Alfredobud/Handyman-project/projetos-madeira/clientes/teste1/cerca-trancada/referencias/referencia-cerca-trancada.jpg

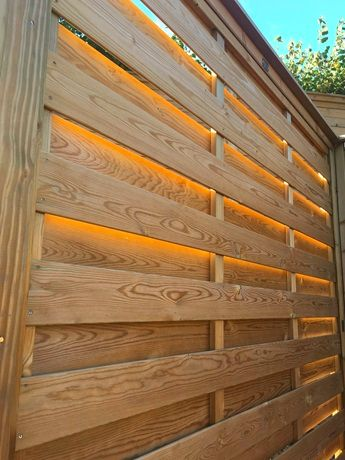
projetos-madeira/clientes/teste1/cerca-trancada/referencias/referencia-cerca-trancada.jpg
