Alfredobud/Handyman-project/projetos-madeira/clientes/bill/kitchen-privacy-screen/referencias/referencia-rev8-6-postes.webp

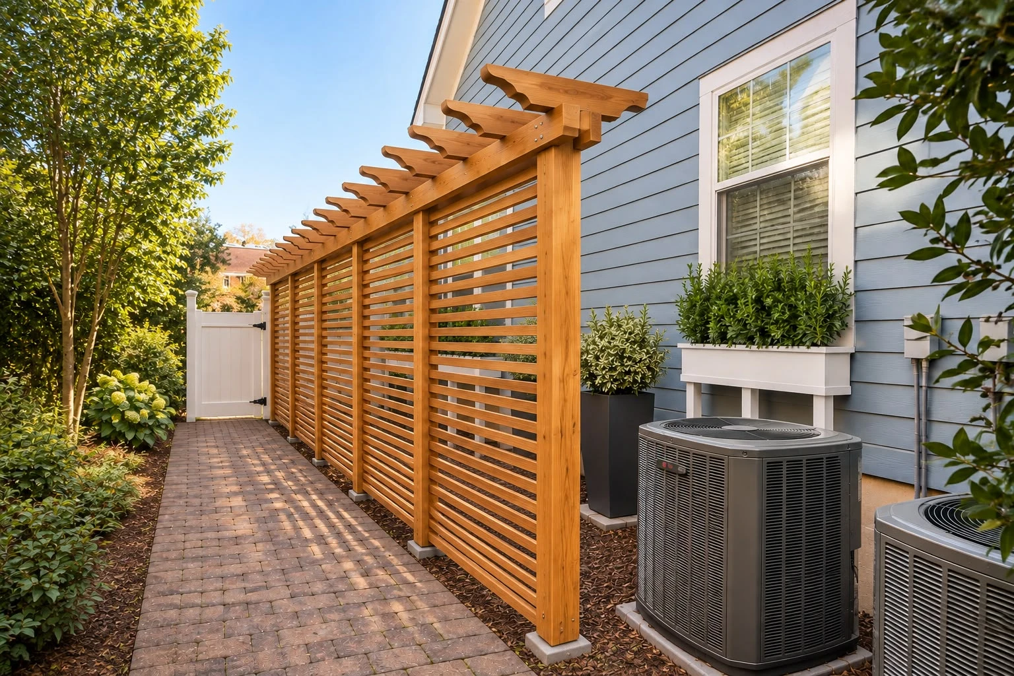
projetos-madeira/clientes/bill/kitchen-privacy-screen/referencias/referencia-rev8-6-postes.webp
