Alfredobud/Handyman-project/projetos-madeira/README.md

# Projetos de Madeira

Hub dos orçamentos e projetos de marcenaria/carpintaria. **Cada orçamento fica na pasta do seu cliente.**

## Estrutura

```
projetos-madeira/
├── README.md                     # este índice
├── clientes/
│   └── <cliente>/                # nome do cliente em minúsculas, com hífens (ex.: bill, john-smith)
│       └── <projeto>/            # ex.: kitchen-privacy-screen
│           ├── README.md         # status, decisões, links e totais
│           ├── referencias/      # fotos, PDFs e croquis recebidos
│           ├── orcamento*/       # spec.json + orcamento.md/.xlsx/.json (uma pasta por opção)
│           ├── desenhos/         # pranchas PDF/SVG/DXF (uma subpasta por opção)
│           ├── propostas/        # documento final para o cliente
│           └── plano-corte/      # plano de corte da oficina (quando aprovado)
└── referencias/                  # material genérico, sem cliente (ex.: planos de cadeira)
```

## Clientes e projetos

| Cliente | Projeto | Status | Proposta |
|---|---|---|---|
| teste1 | [Cerca trançada](clientes/teste1/cerca-trancada/) | Painel pré-fabricado, cedro 5/8" (prévia); completo ~$13,001 (140 ft, 14 painéis) | — |
| Bill | [Kitchen Privacy Screen](clientes/bill/kitchen-privacy-screen/) | Proposta rev. 9 (7 postes, 8 ft, núcleo 4x6): A cedro $7,580 · B pinus $6,742 | [PDF](clientes/bill/kitchen-privacy-screen/propostas/Kitchen-Privacy-Screen-Proposal-rev9.pdf) |

## Referências

- [`referencias/planos/`](referencias/planos/): planos de cadeira Adirondack (YellaWood e Rogue Engineer).

## Skills

- [`orcamento-madeira`](../.claude/skills/orcamento-madeira/SKILL.md): orçamento (materiais + mão de obra) a partir de fotos, PDFs ou croquis.
- [`desenho-madeira`](../.claude/skills/desenho-madeira/SKILL.md): pranchas técnicas 2D (PDF/SVG/DXF) a partir do mesmo `spec.json`.
