Alfredobud/Handyman-project/projetos-madeira/clientes/bill/kitchen-privacy-screen/plano-corte/plano-de-corte-7-postes.pdf

# Plano de corte — oficina

Kitchen Privacy Screen — 7 postes, 100% pinus autoclavado (PT), topo pergolado (Cornelius, NC) · rev. 7 · 7 postes · medidas reais (S4S) · serra 1/8" descontada em cada corte

## 1. Peças (lista de corte)

Marca | Peça | Material | Compr. | Qtd | Operações na oficina | ✓
N Núcleo do poste 4x4 | (enterrar 24"; topo cortado na obra) | Pinus tratado (PT SYP) 4x4 #2 ground contact UC4B | 9'-9 1/2" | 7 | Cortar com sobra de 1 1/2"; cortar o topo na obra no nível laser. Preservativo na ponta enterrada.
S Lateral serrilhada (1" x | 3 1/2") | PT 5/4x6 premium SYP deck board | 7'-5 1/2" | 12 | Ripar 5/4x6 para 3 1/2". 16 encaixes (tabela 1). Deixar a aresta arredondada do lado de fora.
L Lateral lisa, postes de | ponta (1" x 3 1/2") | PT 5/4x6 premium SYP deck board | 7'-5 1/2" | 2 | Ripar 5/4x6 para 3 1/2". Ajustar o topo na obra (etapa 7).
R | Ripa 2x4 deitada | PT 2x4 #2 Prime ground contact (WeatherShield) | 3'-3 1/2" | 96 | Corte com batente; quebrar arestas.
F | Face do poste 2x6 | PT 2x6 #2 Prime ground contact (WeatherShield) | 7'-5 1/2" | 14 | Corte com batente; quebrar arestas.
T1 | Tábua de topo 2x8 — peça 1 de 3 (fazer 2: uma de cada lado) | PT 2x8 #2 Prime ground contact | 7'-11 1/4" | 2 | Entalhes dos caibros conforme tabela 2; furo do parafuso passante em cada poste.
T2 | Tábua de topo 2x8 — peça 2 de 3 (fazer 2: uma de cada lado) | PT 2x8 #2 Prime ground contact | 7'-2 1/2" | 2 | Entalhes dos caibros conforme tabela 2; furo do parafuso passante em cada poste.
T3 | Tábua de topo 2x8 — peça 3 de 3 (fazer 2: uma de cada lado) | PT 2x8 #2 Prime ground contact | 7'-11 1/4" | 2 | Entalhes dos caibros conforme tabela 2; furo do parafuso passante em cada poste.
E Fechamento da ponta | das tábuas de topo 2x8 | PT 2x8 #2 Prime ground contact | 9 1/2" | 2 | Corte reto; quebrar arestas.
K Caibro do pergolado | 2x6 (ponta tipo nuvem) | PT 2x6 #2 Prime ground contact (WeatherShield) | 3'-0" | 7 | Traçar as duas pontas com o gabarito 1:1 (pág. de gabaritos); tico-tico e lixa.

## 2. Lista de compra

Material | Compr. | Tábuas no plano | Comprar (c/ 5% de sobra)
Pinus tratado (PT SYP) 4x4 #2 ground contact UC4B | 10' | 7 | 7
PT 5/4x6 premium SYP deck board | 16' | 7 | 8
PT 2x4 #2 Prime ground contact (WeatherShield) | 10' | 32 | 34
PT 2x6 #2 Prime ground contact (WeatherShield) | 8' | 7 | 7
PT 2x6 #2 Prime ground contact (WeatherShield) | 12' | 7 | 8
PT 2x8 #2 Prime ground contact | 8' | 5 | 6
PT 2x8 #2 Prime ground contact | 10' | 1 | 1

Escolher tábuas retas, sem rachaduras nas pontas. Pinus tratado: preferir KDAT; guardar empilhado com espaçadores até o corte.

## 3. Plano de corte por tábua

Cada barra é uma tábua; cortar da esquerda para a direita, das peças maiores para as menores. Tábuas iguais estão agrupadas (×N).

### Pinus tratado (PT SYP) 4x4 #2 ground contact UC4B

×7 tábua de 10' — 1× N 9'-9 1/2"

| N 9'-9 1/2" | | sobra 2

### PT 5/4x6 premium SYP deck board

×6 tábua de 16' — 2× S 7'-5 1/2"

S 7'-5 1/2" | S 7'-5 1/2" | sobra 12 7/8

×1 tábua de 16' — 2× L 7'-5 1/2"

L 7'-5 1/2" | L 7'-5 1/2" | sobra 12 7/8

+ 1 tábua(s) de sobra para defeitos.

### PT 2x4 #2 Prime ground contact (WeatherShield)

×32 tábua de 10' — 3× R 3'-3 1/2"

R 3'-3 1/2" | R 3'-3 1/2" | R 3'-3 1/2" | sobra 1

+ 2 tábua(s) de sobra para defeitos.

### PT 2x6 #2 Prime ground contact (WeatherShield)

×7 tábua de 12' — 1× F 7'-5 1/2" + 1× K 3'-0"

F 7'-5 1/2" | K 3'-0" | sobra 18 3/8"

×7 tábua de 8' — 1× F 7'-5 1/2"

F 7'-5 1/2" | sobra 6 1/2

+ 1 tábua(s) de sobra para defeitos.

### PT 2x8 #2 Prime ground contact

×2 tábua de 8' — 1× T3 7'-11 1/4"

T3 7'-11 1/4"

×2 tábua de 8' — 1× T2 7'-2 1/2"

T2 7'-2 1/2" | sobra 9 1/2"

×1 tábua de 10' — 1× T1 7'-11 1/4" + 2× E 9 1/2"

T1 7'-11 1/4" | E 9 1/2" | E 9 1/2"sobra 5 1/

×1 tábua de 8' — 1× T1 7'-11 1/4"

T1 7'-11 1/4"

+ 1 tábua(s) de sobra para defeitos.

## 4. Tabela 1 — encaixes da lateral serrilhada (S)

Medidas a partir da base da tábua (lado do chão). Encaixe de 3 9/16" de altura × 1 1/2" de profundidade, na borda do lado do vizinho. Passo 5 3/16". Marcar todas as 12 tábuas juntas (grampeadas lado a lado) ou usar o gabarito 1:1.

Encaixe | De | Até | Encaixe | De | Até
1 | 1 1/2" | 5" | 9 | 3'-7 3/16" | 3'-10 3/4"
2 | 6 11/16" | 10 1/4" | 10 | 4'-7/16" | 4'-4"
3 | 11 7/8" | 15 7/16" | 11 | 4'-5 5/8" | 4'-9 3/16"
4 | 17 1/8" | 20 11/16" | 12 | 4'-10 7/8" | 5'-2 7/16"
5 | 22 5/16" | 2'-1 7/8" | 13 | 5'-4 1/16" | 5'-7 5/8"
6 | 2'-3 9/16" | 2'-7 1/8" | 14 | 5'-9 5/16" | 6'-7/8"
7 | 2'-8 3/4" | 3'-5/16" | 15 | 6'-2 1/2" | 6'-6 1/16"
8 | 3'-2" | 3'-5 9/16" | 16 | 6'-7 3/4" | 6'-11 1/4"

Acima do último encaixe sobram 6 1/4" de tábua até o topo.

## 5. Tabela 2 — entalhes das tábuas de topo (T)

Medidas a partir da ponta esquerda de cada peça (olhando a cerca pelo lado do vizinho). Entalhe de 1 9/16" de largura × 1 1/2" de profundidade na borda de cima. Fazer cada peça em dobro (uma de cada lado do poste). Nas emendas, o entalhe fica dividido entre as duas peças (½ entalhe em cada).

Peça | Compr. | Entalhes (poste: de → até)
T1 | 7'-11 1/4" | P1: 8" → 9 1/2"; P2: 4'-3 1/4" → 4'-4 3/4"; P3: 7'-10 1/2" → 7'-11 1/4" (½)
T2 | 7'-2 1/2" | P3: 0" → 3/4" (½); P4: 3'-6 1/2" → 3'-8"; P5: 7'-1 3/4" → 7'-2 1/2" (½)
T3 | 7'-11 1/4" | P5: 0" → 3/4" (½); P6: 3'-6 1/2" → 3'-8"; P7: 7'-1 3/4" → 7'-3 1/4"

Furo do parafuso passante 1/2": no centro de cada poste, a 2 3/4" da borda de baixo da tábua. Furar as duas tábuas de cada trecho juntas (grampeadas) para alinhar.

## 6. Gabaritos em tamanho real (1:1)

Imprimir em "Tamanho real / 100%" e conferir o quadrado ao lado: deve medir exatamente 1" x 1". Colar em compensado e recortar para fazer o gabarito.

1"

Lateral serrilhada (S): gabarito do passo

### encaixe: 3 9/16" x 1 1/2"

(1º encaixe começa a 1 1/2" da base)

### dente: 1 5/8"

### passo: 5 3/16" (início a início)

← borda do lado do vizinho (encaixes)

↓ para a base da tábua

Gabarito 1:1: ponta do caibro (K), usar nas duas pontas. Caibro 2x6 (5 1/2" de altura), topo da peça em cima; linha tracejada = a peça continua.
