Alfredobud/Handyman-project/projetos-madeira/clientes/bill/kitchen-privacy-screen/referencias/Kitchen_Privacy_Screen_Contractor_Packet.pdf

# KITCHEN PRIVACY SCREEN

Contractor Material List & Build Instructions

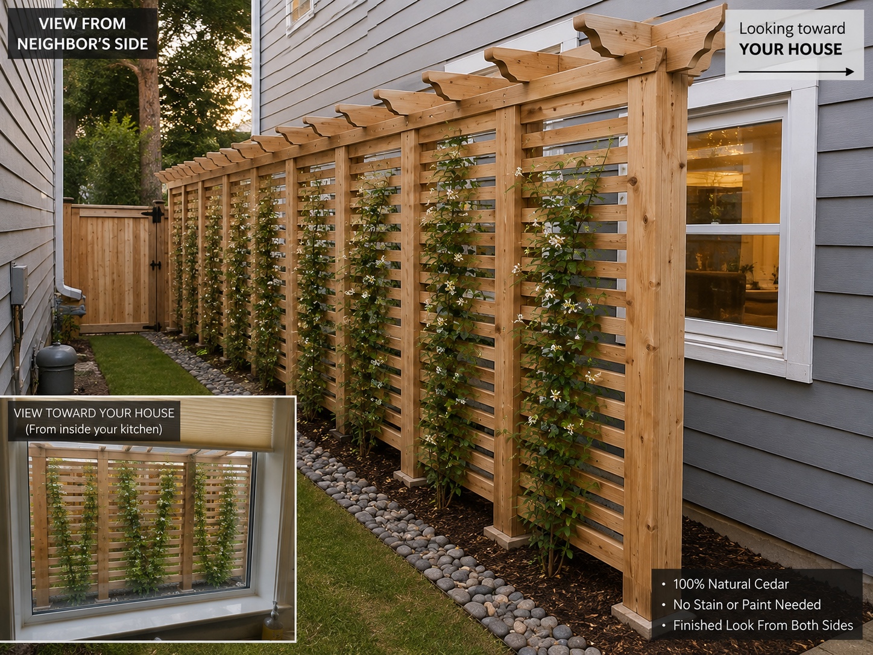
[picture p3: figure]

Reference concept: Low-maintenance horizontal privacy screen with pergola-style top. Final field dimensions and structural details to be verified by contractor.

## Project Requirements

Overall length: 265 in. (22 ft 1 in.) Finished height: approximately 8 ft Layout: straight run
Primary goal: block the direct view between the neighboring home and the kitchen window while maintaining an attractive architectural appearance. The screen should look finished from both properties and require very little routine maintenance. Material strategy: Use pressure-treated structural lumber where structural strength is required, with Trex/composite for the visible horizontal privacy boards and decorative finish components where practical. Standard composite decking is not to be used as a structural substitute for posts or load-bearing beams.

## Material / Parts List

Qty. | Material | Purpose / Notes
6 | 6x6x10' pressure-treated posts | Primary structural posts; contractor to establish final spacing and trim to finished height.
12 | 2x6x8' pressure-treated boards | Horizontal structural rails/framing; quantity may be adjusted after field layout.
8 | 2x6x4' pressure-treated boards | Blocking, end framing and miscellaneous structural framing.
~65 | Trex/composite boards, approx. 1x4 appearance | Horizontal privacy slats. Contractor to select appropriate composite profile and recalculate exact quantity for chosen board width/gaps.
2 | 2x8x12' structural boards | Pergola-style top beam/framing.
2 | 2x8x10' structural boards | Pergola-style top beam/framing.
~14 | Composite or PT 2x4-equivalent decorative piecesTop pergola/trellis appearance; use structural lumber if component carries load.
6 | Heavy-duty 6x6 galvanized/stainless post bases | Keep structural posts elevated from concrete/soil where approved for the installation.
As req. | Concrete | Footings sized by contractor for soil, height, wind loading and local requirements.
As req. | Stainless/exterior-rated fasteners | Structural screws/bolts plus composite-compatible fasteners. Avoid ordinary uncoated steel.
As req. | Composite fascia/wrap/trim | Cover visible PT framing where desired for a finished, low-maintenance appearance.
As req. | Landscape fabric, edging & river rock | Optional ground finish along base of screen.

## Contractor Build Instructions

1. Field layout. Verify the 265-in. run, property line, utilities and exact location before purchasing material. Lay out approximately six structural posts, with final spacing determined by the contractor so the bays are visually even and structurally appropriate.
2. Footings and posts. Construct concrete footings appropriate for an approximately 8-ft-tall privacy screen and local wind/soil conditions. Use heavy-duty post bases where appropriate so wood is not sitting directly in soil or standing water. Set all posts plumb and aligned.
3. Structural framing. Install pressure-treated rails/framing between posts. The structural frame must support the composite slats without relying on the composite itself as a load-bearing member.
4. Privacy slats. Install Trex/composite boards horizontally with consistent spacing. Target approximately 1.5-2 in. of open space between boards unless field mock-up shows a smaller opening is needed for privacy. Follow the composite manufacturer's requirements for span, expansion gaps and fastening.
5. Finished appearance. Both sides must look intentional and finished. Conceal or wrap exposed pressure-treated framing where practical. Avoid an unfinished 'back of fence' appearance on the neighbor's side.
6. Pergola-style top. Create the decorative top shown in the reference image. Any load-bearing beam/rafter must be structural lumber or another material specifically rated for the application. Composite may be used as decorative cladding/trim where suitable.
7. Hardware. Use exterior-rated stainless steel or corrosion-resistant structural hardware compatible with pressure-treated lumber and composite. Follow Trex/composite manufacturer fastening and expansion requirements.
8. Ground treatment. Finish the bottom edge cleanly. If included in quote, install landscape fabric, edging and decorative river rock. Leave appropriate clearance between composite/wood and grade.
9. Planting provision. Leave practical locations for climbing plants to be trained on the screen without interfering with the kitchen window, siding, utilities or structural connections.

## Quote Requested

Please provide labor and materials as separate amounts. Identify the exact composite product/color proposed and any substitutions. Include footing/post installation, structural framing, composite privacy boards, pergola-style top, hardware, trim/wrap and cleanup.

## Before Construction

Contractor to verify underground utilities, property-line/setback requirements, applicable permits/HOA requirements, footing requirements, wind loading and manufacturer installation specifications. Final material quantities are to be field-verified before purchase.

## Acceptance Checklist

■ Approx. 265 in. overall length and approx. 8 ft finished height ■ Posts straight, plumb and evenly laid out
■ Horizontal composite slats evenly spaced
■ Strong privacy from kitchen-window sightline
■ Finished appearance on both sides
■ Pergola-style decorative top matches reference concept
■ No untreated/unprotected structural wood sitting directly in soil
■ Exterior-rated, corrosion-resistant hardware throughout
■ Composite installed to manufacturer span/expansion requirements

■ Jobsite cleaned and all debris removed
