Alfredobud/Handyman-project/projetos-madeira/clientes/bill/kitchen-privacy-screen/desenhos/rev9-b-pinus/privacy-screen.pdf

3'-0"

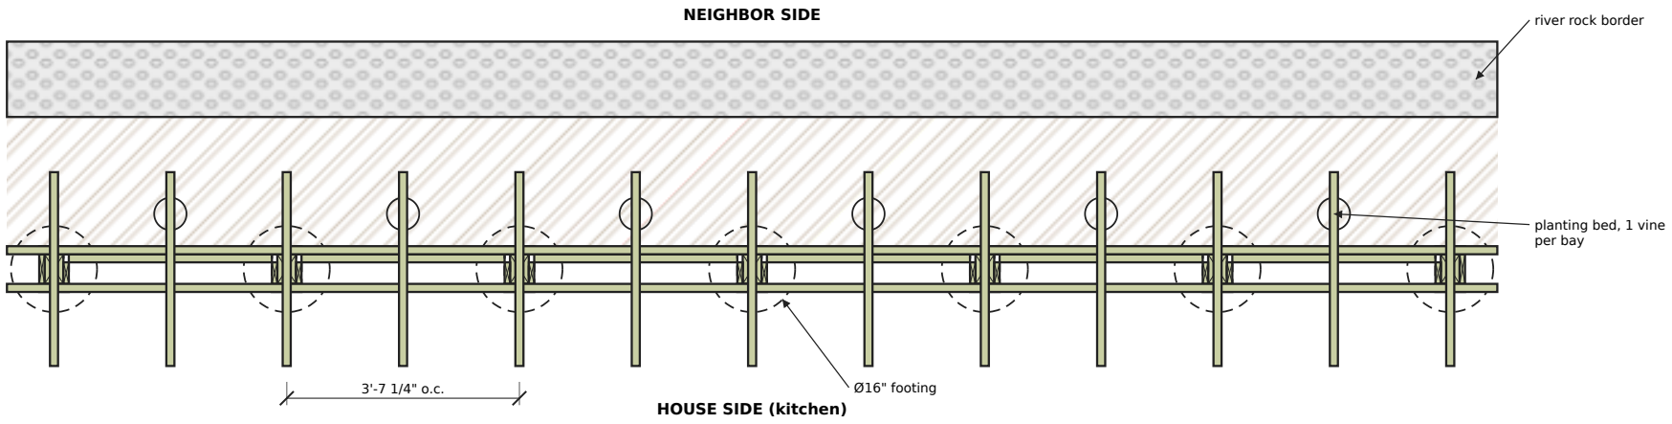
[picture p8: figure]
HOUSE SIDE (kitchen); NEIGHBOR SIDE; planting bed, 1 vine per bay; river rock border; Ø16" footing

# PLAN — TOP VIEW

SCALE 1:32 (3/8" = 1'-0")

1 | 2 | 3 | 4 | 5 | 6 | 7

22'-1"

3'-7 1/4" | 3'-7 1/4" | 3'-7 1/4" | 3'-7 1/4" | 3'-7 1/4" | 3'-7 1/4"

23'-1"

6" 3'-0" 4" 6'-8 3/4" 11 1/4"

8'-0"

GRADE

13 rafters PT pine 2x6 S4S (at posts + mid-bay), cloud-lift ends

24 slats PT pine 2x2 S4S per bay, 2" gap

top-board splice over post 4

end cap

clad post: PT core + cladding (B-3)

A

A

B B

# ELEVATION — NEIGHBOR SIDE

SCALE 1:32 (3/8" = 1'-0")

3'-0"

8'-0"

beam ends (bolted to core)

HOUSE | NEIGHBOR

# SIDE ELEVATION (end view)

SCALE 1:24 (1/2" = 1'-0")

Kitchen Privacy Screen — 7 posts, pressure-treated pine, 8 ft,

### pergola top (Cornelius, NC) — Bill

## Elevation and plan

Date: 2026-11-10 Rev.: 9 By:

Dimensions in feet/inches. Lumber: actual sizes (2x6 = 1 1/2" x 5 1/2"). Verify all dimensions in the field before cutting. Not a structural design.

B-1

### NOTES

1. Overall length 22'-1"; 7 posts at 3'-7 1/4" o.c.; clear bay 3'-1 3/4".
2. Bay/post = 6.86 ≈ φ^4 (Fibonacci 89/13); span 3'-1 3/4" > 36" limit (< 48" max).
3. Post cores embedded 3'-0" in concrete over 6" gravel; holes by machine auger.
4. Call NC811 before digging. Verify property line, setbacks and HOA.
5. Fasteners: coated trim-head deck screws (ACQ-rated), countersunk.
6. 24 slats per bay, 2" gap set by the notched side boards.
7. All posts 5 1/2" wide, faces flush. Parts marked YES are pre-cut in the shop.
8. All lumber: Southern Yellow Pine #2, pressure-treated, S4S; cores ground contact (UC4B).

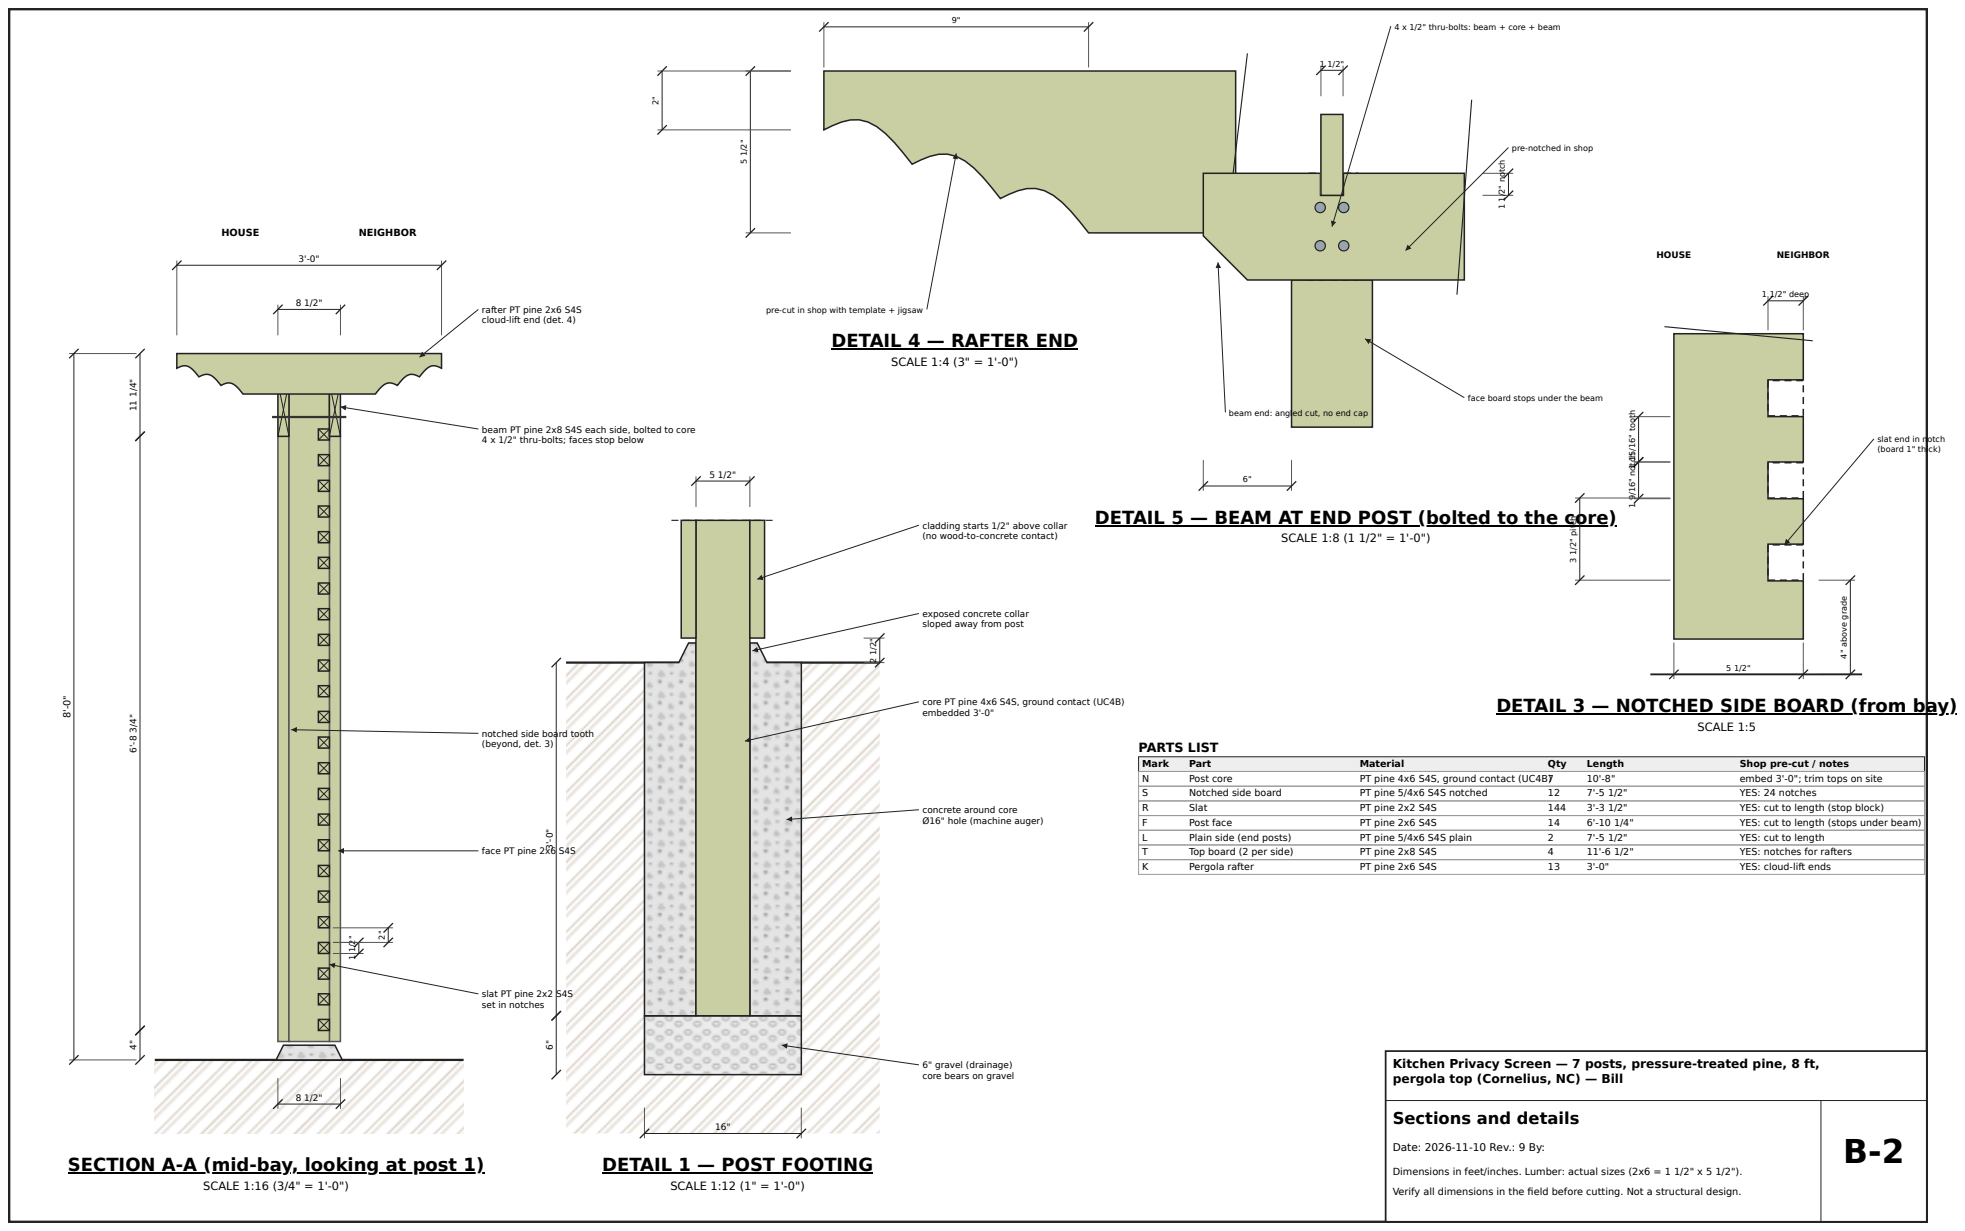
[picture p9: page 2]
HOUSE; NEIGHBOR; SCALE 1:16 (3/4" = 1'-0"); SCALE 1:12 (1" = 1'-0"); SCALE 1:4 (3" = 1'-0"); 1 1/2" notch; SCALE 1:8 (1 1/2" = 1'-0"); 1 1/2" deep; 1 9/16" notch 1 15/16" tooth; 3 1/2" pitch; 4" above grade; SCALE 1:5; PARTS LIST; Mark; Part; Material; Qty; Length; Shop pre-cut / notes; Post core; PT pine 4x6 S4S, ground contact (UC4B7); embed 3'-0"; trim tops on site; Notched side board; PT pine 5/4x6 S4S notched; YES: 24 notches; Slat; PT pine 2x2 S4S; YES: cut to length (stop block)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

4 x 1/2" thru-bolts: beam + core + beam

pre-notched in shop

rafter PT pine 2x6 S4S
cloud-lift end (det. 4)

pre-cut in shop with template + jigsaw

DETAIL 4 — RAFTER END

face board stops under the beam

beam end: angled cut, no end cap

beam PT pine 2x8 S4S each side, bolted to core
4 x 1/2" thru-bolts; faces stop below

slat end in notch
(board 1" thick)

DETAIL 5 — BEAM AT END POST (bolted to the core)

cladding starts 1/2" above collar
(no wood-to-concrete contact)

exposed concrete collar
sloped away from post

core PT pine 4x6 S4S, ground contact (UC4B)
embedded 3'-0"

DETAIL 3 — NOTCHED SIDE BOARD (from bay)

notched side board tooth
(beyond, det. 3)

concrete around core
Ø16" hole (machine auger)

face PT pine 2x6 S4S

slat PT pine 2x2 S4S
set in notches

6" gravel (drainage)
core bears on gravel

Kitchen Privacy Screen — 7 posts, pressure-treated pine, 8 ft,
pergola top (Cornelius, NC) — Bill

Sections and details

Date: 2026-11-10 Rev.: 9 By:

SECTION A-A (mid-bay, looking at post 1)

DETAIL 1 — POST FOOTING

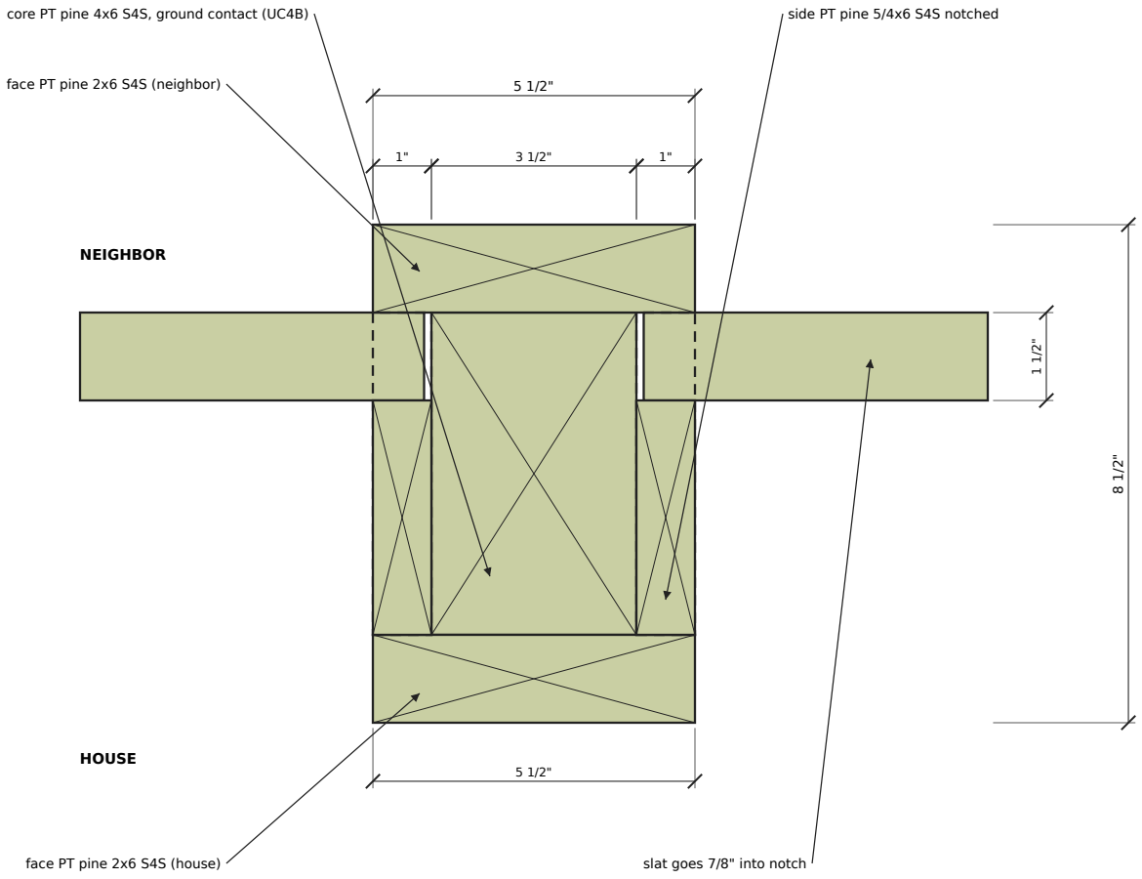
[picture p10: figure]
face PT pine 2x6 S4S (neighbor); face PT pine 2x6 S4S (house); side PT pine 5/4x6 S4S notched; slat goes 7/8" into notch; HOUSE; NEIGHBOR

core PT pine 4x6 S4S, ground contact (UC4B)

# DETAIL 2a — INTERMEDIATE POST, SECTION B-B

SCALE 1:3

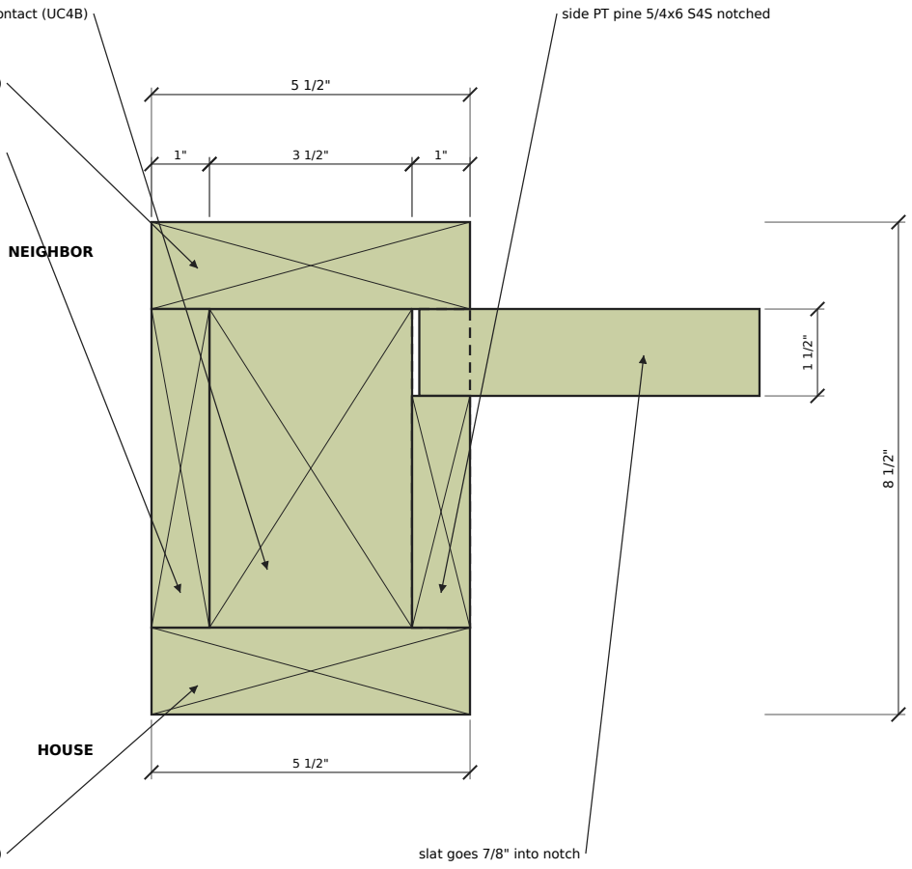
[picture p11: figure]
side PT pine 5/4x6 S4S notched; slat goes 7/8" into notch; HOUSE; NEIGHBOR

core PT pine 4x6 S4S, ground contact (UC4B)

face PT pine 2x6 S4S (neighbor)

face PT pine 2x6 S4S (house) side PT pine 5/4x6 S4S plain

# DETAIL 2b — END POST (1 and 7)

SCALE 1:3

# | INSTALLATION SEQUENCE

1 | HOLES: lay out 7 post centers at 3'-7 1/4" o.c.; dig Ø16" x 3'-6" with rented machine auger; 6" gravel.
2 | POSTS: set PT pine 4x6 S4S, ground contact (UC4B) cores 3'-0" deep, plumb and brace, concrete with sloped collar. Cure 48 h.
3 | LEVEL TOPS: cut all cores to 7'-8" above grade (laser level).
4 | NOTCHED SIDE BOARDS (pre-cut): fasten to core sides from the neighbor side, notches facing neighbor.
5 | SLATS (pre-cut): drop into notches from the neighbor side, bottom to top; 1 screw per end.
6 | FRONT CLOSURE: PT pine 2x6 S4S face boards on both faces (closes the notches and locks the slats).
7 | SIDE CLOSURE: PT pine 5/4x6 S4S plain on the outer side of end posts 1 and 7.
8 | BEAMS (pre-notched): PT pine 2x8 S4S each side, bolted straight to the core above the face boards, 4 x 1/2" thru-bolts per post; splice over post 4.
9 | PERGOLA RAFTERS (pre-cut): 13 into top-board notches (posts + mid-bay); hidden trim-head screws.

Kitchen Privacy Screen — 7 posts, pressure-treated pine, 8 ft,

### pergola top (Cornelius, NC) — Bill

## Clad post (PT core + cladding) and installation

Date: 2026-11-10 Rev.: 9 By:

B-3
