Alfredobud/Handyman-project/projetos-madeira/clientes/bill/kitchen-privacy-screen/desenhos/arquivo-rev7/10-postes/privacy-screen.pdf

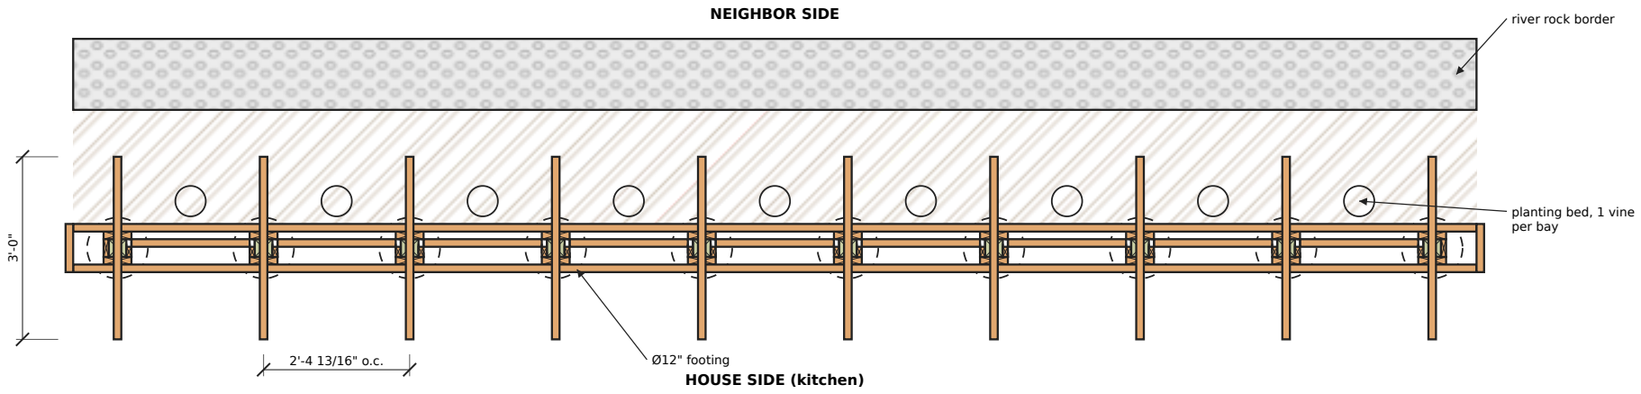
[picture p12: figure]
HOUSE SIDE (kitchen); NEIGHBOR SIDE; planting bed, 1 vine per bay; river rock border; Ø12" footing

# PLAN — TOP VIEW

SCALE 1:32 (3/8" = 1'-0")

1 | 2 | 3 | 4 | 5 | 6 | 7 | 8 | 9 | 10

22'-1"

2'-4 13/16" | 2'-4 13/16" | 2'-4 13/16" | 2'-4 13/16" | 2'-4 13/16" | 2'-4 13/16" | 2'-4 13/16" | 2'-4 13/16" | 2'-4 13/16"

23'-4"

6" 2'-0" 4" 6'-8 3/4" 11 1/4"

8'-0"

GRADE

10 rafters Cedar 2x6 S4S (1 per post), cloud-lift ends

16 slats Cedar 2x4 S4S (flat) per bay, 1 11/16" gap

top-board splices over posts 4, 7

end cap

composite post (A-3)

A

A

B B

# ELEVATION — NEIGHBOR SIDE

SCALE 1:32 (3/8" = 1'-0")

3'-0"

8'-0"

end cap

HOUSE | NEIGHBOR

# SIDE ELEVATION (end view)

SCALE 1:24 (1/2" = 1'-0")

### Kitchen Privacy Screen — 10 posts, cedar with pergola top (Cornelius, NC) — Bill

## Elevation and plan

Date: 2026-11-10 Rev.: 7 By:

Dimensions in feet/inches. Lumber: actual sizes (2x6 = 1 1/2" x 5 1/2"). Verify all dimensions in the field before cutting. Not a structural design.

A-1

### NOTES

1. Overall length 22'-1"; 10 posts at 2'-4 13/16" o.c.; clear bay 23 5/16".
2. Bay/post = 4.24 ≈ φ^3 (Fibonacci 55/13); span 23 5/16" < 36" (low warping risk).
3. Post cores embedded 2'-0" in concrete over 6" gravel; holes by machine auger.
4. Call NC811 before digging. Verify property line, setbacks and HOA.
5. Fasteners: coated trim-head deck screws (ACQ-rated), countersunk.
6. 16 slats per bay, 1 11/16" gap set by the notched side boards.
7. All posts 5 1/2" wide, faces flush. Parts marked YES are pre-cut in the shop.
8. Cedar = Western Red Cedar, kiln-dried, S4S (planed 4 sides).
9. PT = Southern Yellow Pine #2, ground contact.

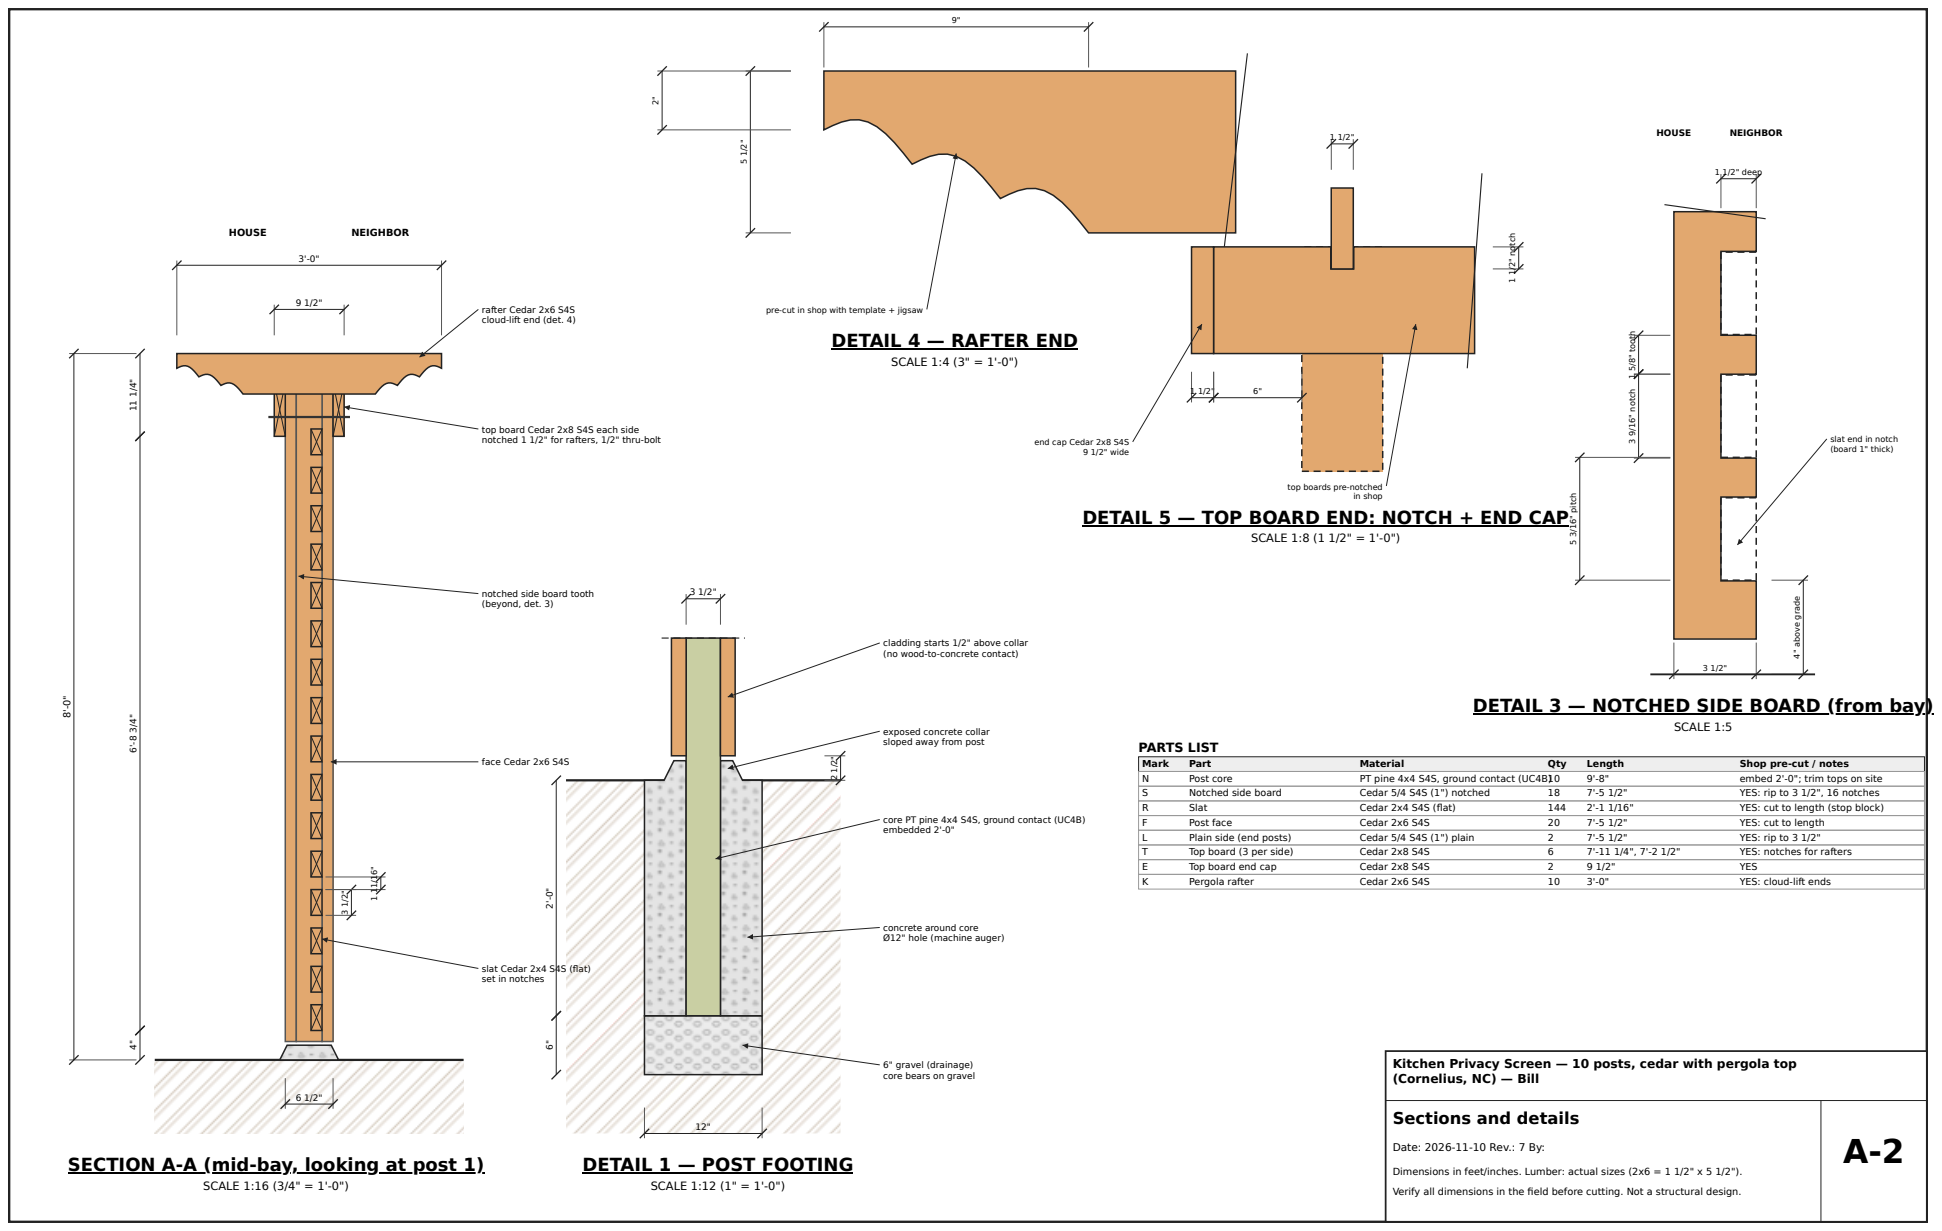
[picture p13: page 2]
face Cedar 2x6 S4S; HOUSE; NEIGHBOR; SCALE 1:16 (3/4" = 1'-0"); SCALE 1:12 (1" = 1'-0"); SCALE 1:4 (3" = 1'-0"); 1 1/2" notch; 9 1/2" wide; in shop; SCALE 1:8 (1 1/2" = 1'-0"); 1 1/2" deep; 3 9/16" notch 1 5/8" tooth; 5 3/16" pitch; 4" above grade; SCALE 1:5; PARTS LIST; Mark; Part; Material; Qty; Length; Shop pre-cut / notes; Post core; PT pine 4x4 S4S, ground contact (UC4B1) 0; embed 2'-0"; trim tops on site; Notched side board; Cedar 5/4 S4S (1") notched; YES: rip to 3 1/2", 16 notches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

rafter Cedar 2x6 S4S
cloud-lift end (det. 4)

pre-cut in shop with template + jigsaw

DETAIL 4 — RAFTER END

top board Cedar 2x8 S4S each side
notched 1 1/2" for rafters, 1/2" thru-bolt

end cap Cedar 2x8 S4S

slat end in notch
(board 1" thick)

top boards pre-notched

DETAIL 5 — TOP BOARD END: NOTCH + END CAP

notched side board tooth
(beyond, det. 3)

cladding starts 1/2" above collar
(no wood-to-concrete contact)

DETAIL 3 — NOTCHED SIDE BOARD (from bay)

exposed concrete collar
sloped away from post

core PT pine 4x4 S4S, ground contact (UC4B)
embedded 2'-0"

concrete around core
Ø12" hole (machine auger)

slat Cedar 2x4 S4S (flat)
set in notches

6" gravel (drainage)
core bears on gravel

Kitchen Privacy Screen — 10 posts, cedar with pergola top
(Cornelius, NC) — Bill

Sections and details

Date: 2026-11-10 Rev.: 7 By:

SECTION A-A (mid-bay, looking at post 1)

DETAIL 1 — POST FOOTING

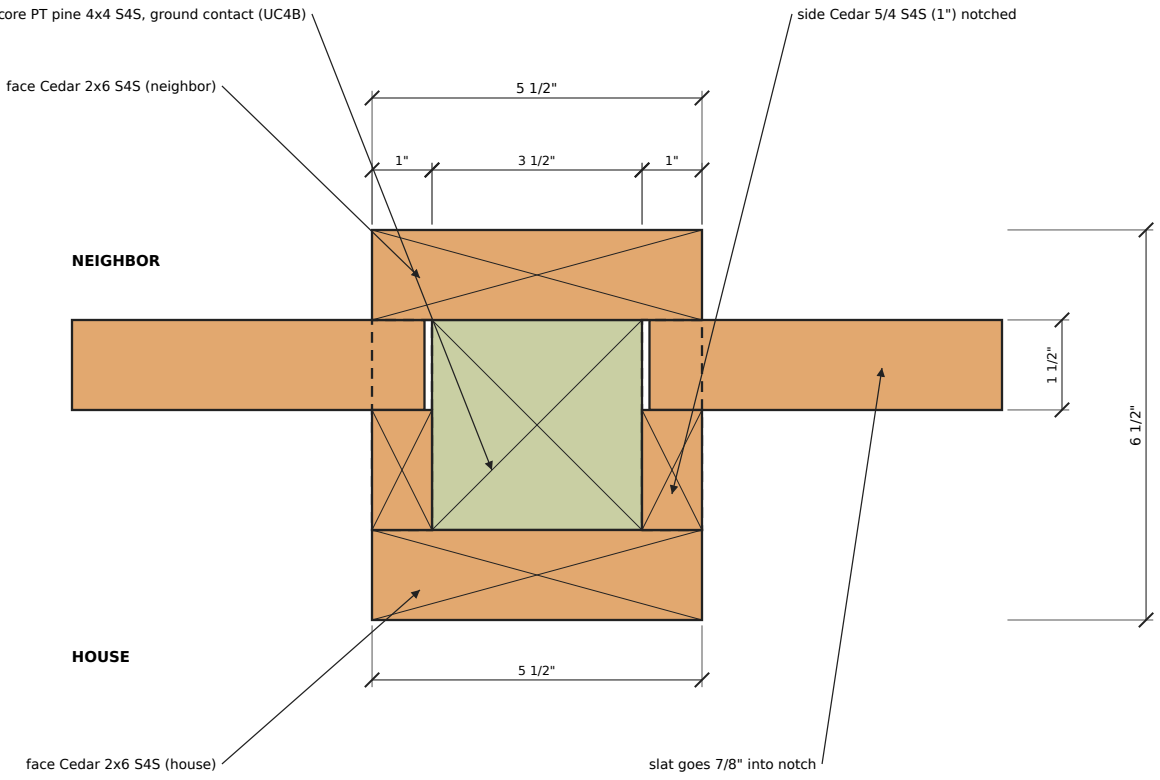
[picture p14: figure]
face Cedar 2x6 S4S (neighbor); face Cedar 2x6 S4S (house); side Cedar 5/4 S4S (1") notched; slat goes 7/8" into notch; HOUSE; NEIGHBOR

core PT pine 4x4 S4S, ground contact (UC4B)

# DETAIL 2a — INTERMEDIATE POST, SECTION B-B

SCALE 1:3

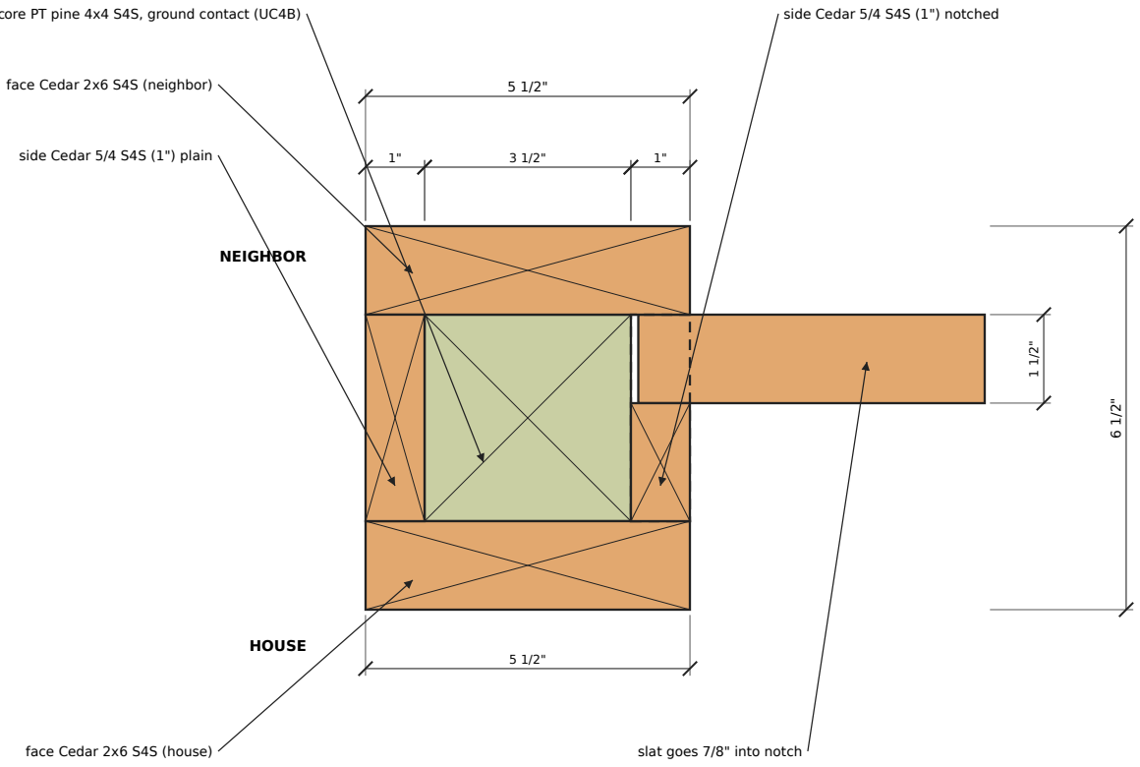
[picture p15: figure]
face Cedar 2x6 S4S (neighbor); face Cedar 2x6 S4S (house); side Cedar 5/4 S4S (1") plain; side Cedar 5/4 S4S (1") notched; slat goes 7/8" into notch; HOUSE; NEIGHBOR

core PT pine 4x4 S4S, ground contact (UC4B)

# DETAIL 2b — END POST (1 and 10)

SCALE 1:3

# | INSTALLATION SEQUENCE

1 | HOLES: lay out 10 post centers at 2'-4 13/16" o.c.; dig Ø12" x 2'-6" with rented machine auger; 6" gravel.
2 | POSTS: set PT 4x4 cores 2'-0" deep, plumb and brace, pour concrete with sloped collar. Cure 48 h.
3 | LEVEL TOPS: cut all cores to 7'-8" above grade (laser level).
4 | NOTCHED SIDE BOARDS (pre-cut): fasten to core sides from the neighbor side, notches facing neighbor.
5 | SLATS (pre-cut): drop into notches from the neighbor side, bottom to top; 1 screw per end.
6 | FRONT CLOSURE: 2x6 face boards on both faces (closes the notches and locks the slats).
7 | SIDE CLOSURE: 1" plain side board on the outer side of end posts 1 and 10.
8 | TOP BOARDS (pre-notched): 2x8 each side of the posts, 1/2" thru-bolt per post; splices over posts 4, 7.
9 | END CAPS (pre-cut): close the ends of the top boards for a solid-beam look.
10 | PERGOLA RAFTERS (pre-cut): drop into top-board notches, 1 per post; hidden trim-head screws.

### Kitchen Privacy Screen — 10 posts, cedar with pergola top (Cornelius, NC) — Bill

## Composite post and installation

Date: 2026-11-10 Rev.: 7 By:

A-3
