Alfredobud/Handyman-project/projetos-madeira/clientes/bill/kitchen-privacy-screen/desenhos/arquivo-rev7/7-postes/privacy-screen.pdf

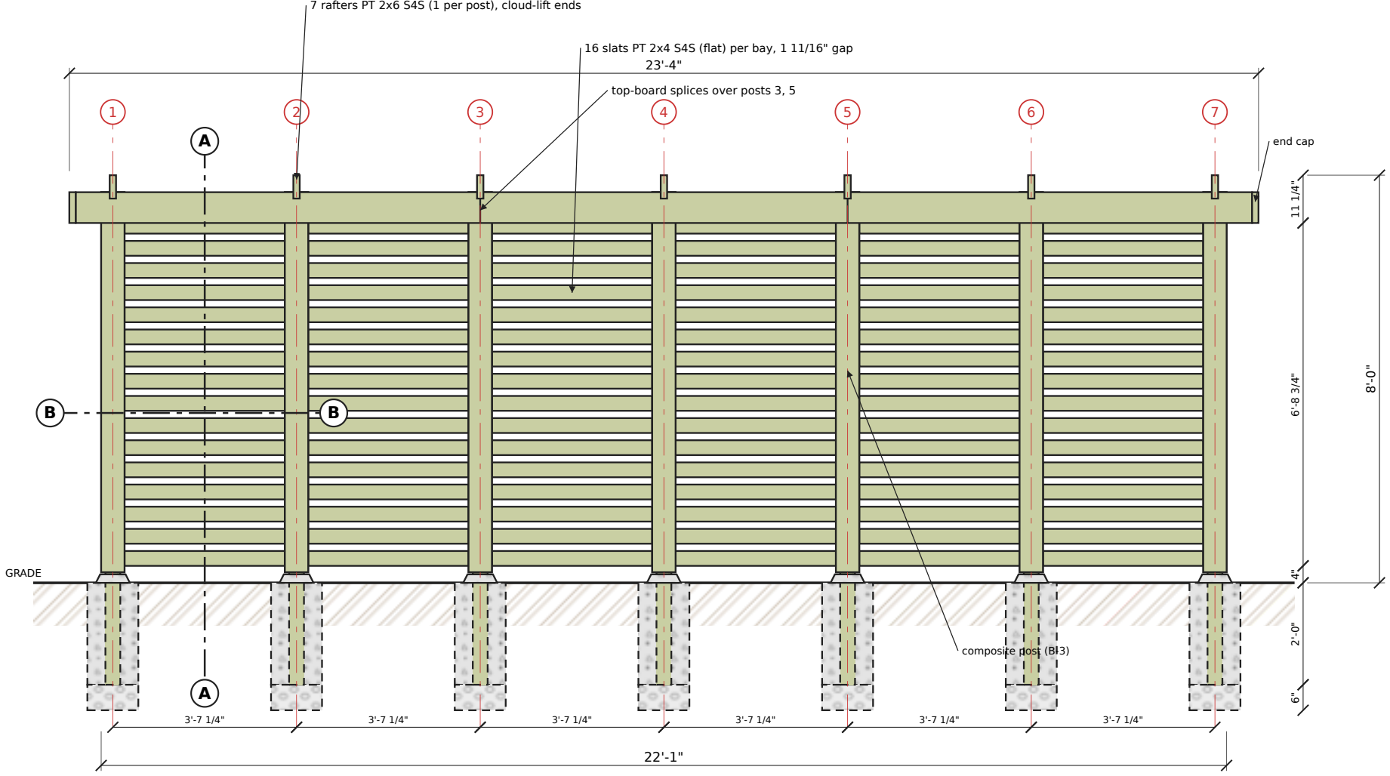
[picture p16: figure]
GRADE; top-board splices over posts 3, 5; end cap; composite post (B-3)
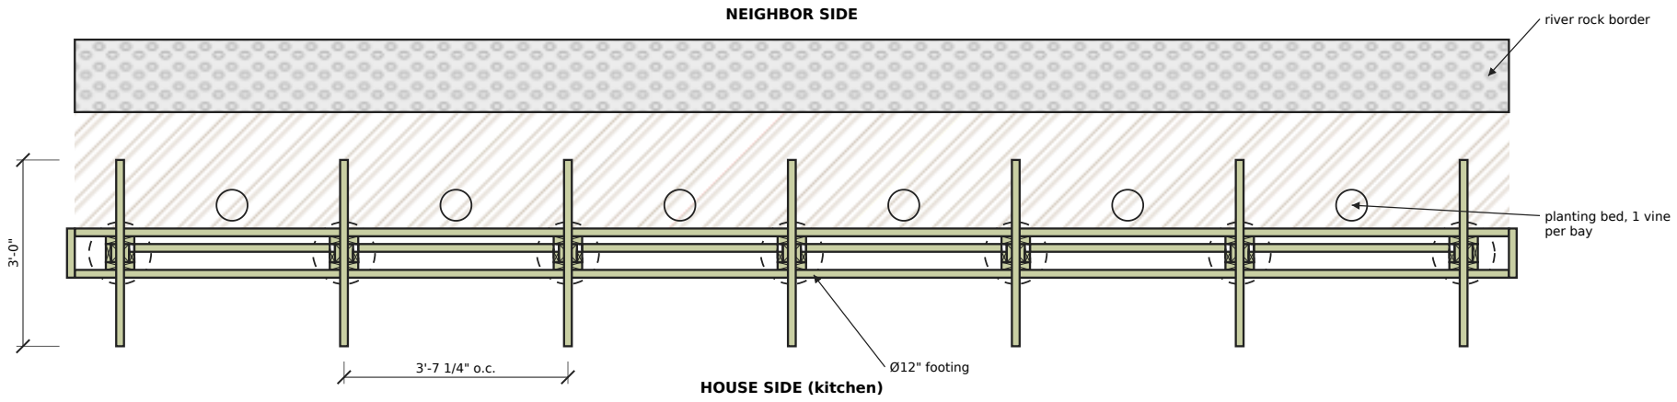
[picture p17: figure]
HOUSE SIDE (kitchen); NEIGHBOR SIDE; planting bed, 1 vine per bay; river rock border; Ø12" footing

# PLAN — TOP VIEW

SCALE 1:32 (3/8" = 1'-0")

7 rafters PT 2x6 S4S (1 per post), cloud-lift ends

16 slats PT 2x4 S4S (flat) per bay, 1 11/16" gap

# ELEVATION — NEIGHBOR SIDE

SCALE 1:32 (3/8" = 1'-0")

3'-0"

8'-0"

end cap

HOUSE | NEIGHBOR

# SIDE ELEVATION (end view)

SCALE 1:24 (1/2" = 1'-0")

### Kitchen Privacy Screen — 7 posts, pressure-treated pine with pergola top (Cornelius, NC) — Bill

## Elevation and plan

Date: 2026-11-10 Rev.: 7 By:

Dimensions in feet/inches. Lumber: actual sizes (2x6 = 1 1/2" x 5 1/2"). Verify all dimensions in the field before cutting. Not a structural design.

B-1

### NOTES

1. Overall length 22'-1"; 7 posts at 3'-7 1/4" o.c.; clear bay 3'-1 3/4".
2. Bay/post = 6.86 ≈ φ^4 (Fibonacci 89/13); span 3'-1 3/4" > 36" limit (< 48" max).
3. Post cores embedded 2'-0" in concrete over 6" gravel; holes by machine auger.
4. Call NC811 before digging. Verify property line, setbacks and HOA.
5. Fasteners: coated trim-head deck screws (ACQ-rated), countersunk.
6. 16 slats per bay, 1 11/16" gap set by the notched side boards.
7. All posts 5 1/2" wide, faces flush. Parts marked YES are pre-cut in the shop.
8. All lumber: Southern Yellow Pine #2, pressure-treated, S4S; posts ground contact (UC4B).

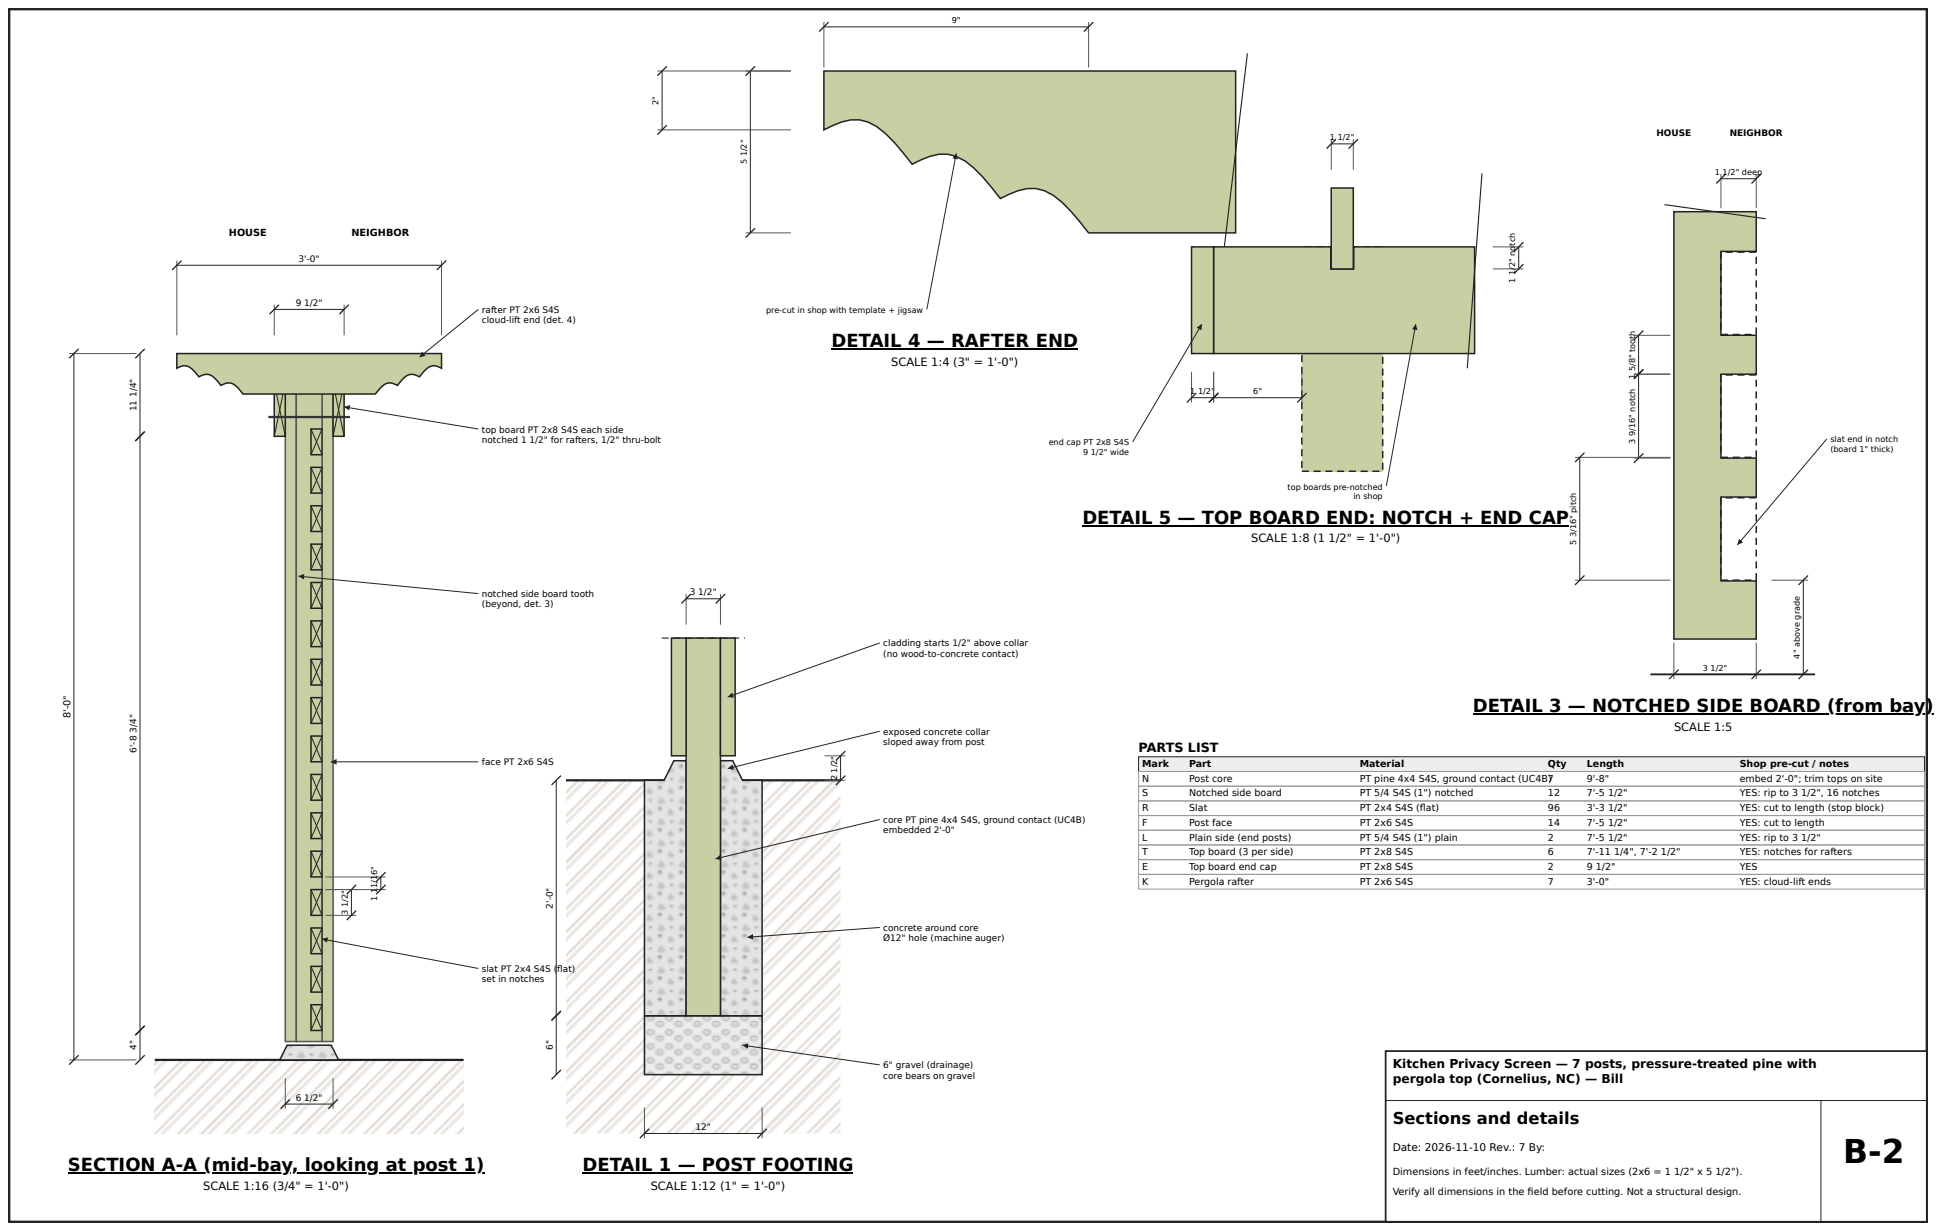
[picture p18: page 2]
face PT 2x6 S4S; HOUSE; NEIGHBOR; SCALE 1:16 (3/4" = 1'-0"); SCALE 1:12 (1" = 1'-0"); SCALE 1:4 (3" = 1'-0"); 1 1/2" notch; 9 1/2" wide; in shop; SCALE 1:8 (1 1/2" = 1'-0"); 1 1/2" deep; 3 9/16" notch 1 5/8" tooth; 5 3/16" pitch; 4" above grade; SCALE 1:5; PARTS LIST; Mark; Part; Material; Qty; Length; Shop pre-cut / notes; Post core; PT pine 4x4 S4S, ground contact (UC4B7); embed 2'-0"; trim tops on site; Notched side board; PT 5/4 S4S (1") notched; YES: rip to 3 1/2", 16 notches; Slat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

rafter PT 2x6 S4S
cloud-lift end (det. 4)

pre-cut in shop with template + jigsaw

DETAIL 4 — RAFTER END

top board PT 2x8 S4S each side
notched 1 1/2" for rafters, 1/2" thru-bolt

end cap PT 2x8 S4S

slat end in notch
(board 1" thick)

top boards pre-notched

DETAIL 5 — TOP BOARD END: NOTCH + END CAP

notched side board tooth
(beyond, det. 3)

cladding starts 1/2" above collar
(no wood-to-concrete contact)

DETAIL 3 — NOTCHED SIDE BOARD (from bay)

exposed concrete collar
sloped away from post

core PT pine 4x4 S4S, ground contact (UC4B)
embedded 2'-0"

concrete around core
Ø12" hole (machine auger)

slat PT 2x4 S4S (flat)
set in notches

6" gravel (drainage)
core bears on gravel

Kitchen Privacy Screen — 7 posts, pressure-treated pine with
pergola top (Cornelius, NC) — Bill

Sections and details

Date: 2026-11-10 Rev.: 7 By:

SECTION A-A (mid-bay, looking at post 1)

DETAIL 1 — POST FOOTING

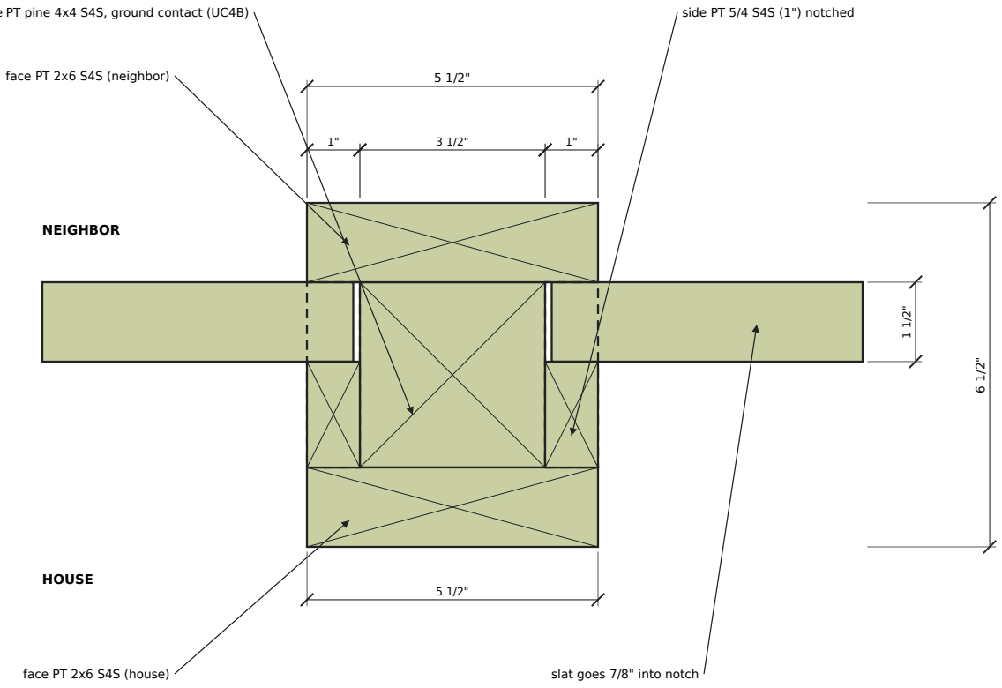
[picture p19: figure]
face PT 2x6 S4S (neighbor); face PT 2x6 S4S (house); side PT 5/4 S4S (1") notched; slat goes 7/8" into notch; HOUSE; NEIGHBOR

core PT pine 4x4 S4S, ground contact (UC4B)

# DETAIL 2a — INTERMEDIATE POST, SECTION B-B

SCALE 1:3

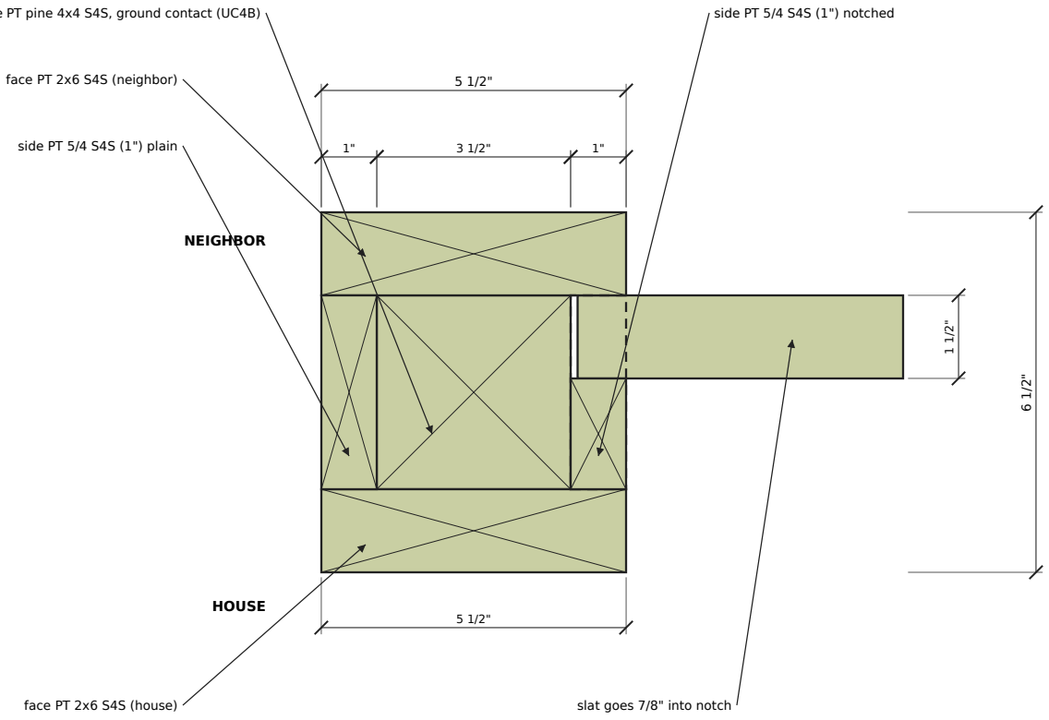
[picture p20: figure]
face PT 2x6 S4S (neighbor); face PT 2x6 S4S (house); side PT 5/4 S4S (1") plain; side PT 5/4 S4S (1") notched; slat goes 7/8" into notch; HOUSE; NEIGHBOR

core PT pine 4x4 S4S, ground contact (UC4B)

# DETAIL 2b — END POST (1 and 7)

SCALE 1:3

# | INSTALLATION SEQUENCE

1 | HOLES: lay out 7 post centers at 3'-7 1/4" o.c.; dig Ø12" x 2'-6" with rented machine auger; 6" gravel.
2 | POSTS: set PT 4x4 cores 2'-0" deep, plumb and brace, pour concrete with sloped collar. Cure 48 h.
3 | LEVEL TOPS: cut all cores to 7'-8" above grade (laser level).
4 | NOTCHED SIDE BOARDS (pre-cut): fasten to core sides from the neighbor side, notches facing neighbor.
5 | SLATS (pre-cut): drop into notches from the neighbor side, bottom to top; 1 screw per end.
6 | FRONT CLOSURE: 2x6 face boards on both faces (closes the notches and locks the slats).
7 | SIDE CLOSURE: 1" plain side board on the outer side of end posts 1 and 7.
8 | TOP BOARDS (pre-notched): 2x8 each side of the posts, 1/2" thru-bolt per post; splices over posts 3, 5.
9 | END CAPS (pre-cut): close the ends of the top boards for a solid-beam look.
10 | PERGOLA RAFTERS (pre-cut): drop into top-board notches, 1 per post; hidden trim-head screws.

### Kitchen Privacy Screen — 7 posts, pressure-treated pine with pergola top (Cornelius, NC) — Bill

## Composite post and installation

Date: 2026-11-10 Rev.: 7 By:

B-3
