Alfredobud/Handyman-project/projetos-madeira/clientes/bill/kitchen-privacy-screen/tempo-por-etapa.md

# Tempo de mão de obra por etapa — Kitchen Privacy Screen

Horas do orçamento atual, a $60/h. Dia = 8 h. Paisagismo é extra e não está incluído.

| Etapa | Descrição | A — 10 postes (h) | ($) | B — 7 postes (h) | ($) |
|---|---|---:|---:|---:|---:|
| Oficina | Pré-corte (antes da obra) | 37.5 | $2,251 | 27.5 | $1,648 |
| 1 | Furos (marcação + escavação mecanizada + retirar/devolver equipamento) | 3.5 | $210 | 3.0 | $183 |
| 2 | Postes (brita, prumo, escora, concreto, colar) | 4.5 | $270 | 3.1 | $189 |
| 3 | Nivelar topos | 1.5 | $90 | 1.1 | $63 |
| 4 | Serrilhados (lado do vizinho) | 1.4 | $86 | 1.0 | $58 |
| 5 | Ripas | 3.6 | $216 | 2.4 | $144 |
| 6 | Fechamento frontal (faces 2x6) | 1.6 | $96 | 1.1 | $67 |
| 7 | Fechamento lateral (postes de ponta) | 2.0 | $120 | 2.0 | $120 |
| 8 | Tábuas de topo | 3.0 | $180 | 3.0 | $180 |
| 9 | Fechamento das pontas | 0.5 | $30 | 0.5 | $30 |
| 10 | Caibros do pergolado | 1.5 | $90 | 1.1 | $63 |
| Outros | Compras/transporte e limpeza | 5.0 | $300 | 16.0 | $960 |
| | **Subtotal oficina** | **37.5** | **$2,251** | **27.5** | **$1,648** |
| | **Subtotal obra** | **28.1** | **$1,688** | **34.3** | **$2,057** |
| | **TOTAL** | **65.7** | **$3,940** | **61.8** | **$3,705** |
| | Dias de 8 h (oficina / obra) | 4.7 / 3.5 | | 3.4 / 4.3 | |

## Como cada etapa foi calculada

| Etapa | Tarefa | Unid. | Qtd A | Qtd B | h/unid. |
|---|---|---|---:|---:|---:|
| Oficina | Oficina: ripar 5/4 p/ 3 1/2 + marcar com gabarito + cortar os encaixes (dado/tupia ou serra + formão) | peca | 18 | 12 | 0.6 |
| Oficina | Oficina: corte no comprimento com batente (ripas;  faces) | peca | 164 | 110 | 0.04 |
| Oficina | Oficina: ripar tábua na largura (serra de bancada) | peca | 20 | 14 | 0.1 |
| Oficina | Oficina: tábua de topo: corte;  entalhes dos caibros e furos dos parafusos | peca | 6 | 6 | 0.6 |
| Oficina | Oficina: fechamento de ponta das tábuas de topo | peca | 2 | 2 | 0.25 |
| Oficina | Oficina: caibro com ponta tipo nuvem (gabarito + tico-tico + lixa) | peca | 10 | 7 | 0.6 |
| Oficina | Oficina: gabaritos do serrilhado e do caibro | verba | 1 | 1 | 2 |
| Oficina | Oficina: quebrar arestas/lixar peças visíveis antes de levar à obra | peca | 202 | 139 | 0.03 |
| 1 | Obra: retirar e devolver o equipamento de escavação alugado | verba | 1 | 1 | 1 |
| 1 | Locação/marcação da linha e conferência de divisa e utilidades | verba | 1 | 1 | 1 |
| 1 | Obra: furo com mini skid steer/perfuratriz hidráulica alugada (posicionar + furar + limpar) | furo | 10 | 7 | 0.15 |
| 2 | Obra: brita no fundo + prumo/escora + concreto + colar com caimento | poste | 10 | 7 | 0.45 |
| 3 | Obra: marcar com laser e cortar o topo do núcleo | poste | 10 | 7 | 0.15 |
| 4 | Obra: fixar lateral serrilhada pré-cortada no núcleo | peca | 18 | 12 | 0.08 |
| 5 | Obra: encaixar ripa pré-cortada + 1 parafuso por ponta | peca | 144 | 96 | 0.025 |
| 6 | Obra: fixar face 2x6 pré-cortada (cola + parafuso trim-head) | peca | 20 | 14 | 0.08 |
| 7 | Obra: fechamento lateral dos postes de ponta, incluindo os cortes de ajuste no topo (1 h por ponta) | peca | 2 | 2 | 1 |
| 8 | Obra: içar tábua de topo entalhada + furar + parafuso passante | peca | 6 | 6 | 0.5 |
| 9 | Obra: fixar fechamento da ponta das tábuas de topo | peca | 2 | 2 | 0.25 |
| 10 | Obra: assentar caibro no entalhe + parafuso trim-head oculto | peca | 10 | 7 | 0.15 |
| Outros | Compra e transporte de material (sem frete de loja) | verba | 1 | 1 | 3 |
| Outros | Limpeza da obra e descarte de entulho | verba | 1 | 1 | 2 |
| Outros | Aplicação de stain/selador por pé quadrado (uma demão) | sqft | 0 | 450 | 0.02 |
| Outros | Visita de retorno para stain após secagem da madeira | h | 0 | 2 | 1 |

_Etapa 2: cura de 48 h do concreto antes das etapas 3–10 (espera, não cobrada). Taxas em `.claude/skills/orcamento-madeira/references/produtividade.csv`._
