Alfredobud/Handyman-project/projetos-madeira/clientes/bill/kitchen-privacy-screen/analise-pinus-autoclavado.md

# Análise: pinus autoclavado (PT) na cerca

**Pinus autoclavado** nos EUA é o *pressure-treated Southern Yellow Pine* (SYP), tratado hoje com cobre (ACQ, CA ou MCA). O CCA não é mais vendido para uso residencial.

## Comparação de custo (Cornelius, NC — rev. 3: 11 postes compostos — valores históricos; ver README para a rev. 7, ripas 2x4 encaixadas)

| Cenário | Materiais (c/ 8.25%) | Mão de obra ($60/h) | Taxa | **Total** |
|---|---:|---:|---:|---:|
| **A — núcleo PT + tudo visível em cedro** ([orçamento](orcamento/orcamento.md)) | $4,252 | $5,835 (97 h) | $150 | **$10,237** |
| **B — 100% PT** ([orçamento](orcamento-pt/orcamento.md)) | $2,433 | $6,495 (108 h) | $150 | **$9,078** |
| Diferença | −$1,819 | +$660 (+11 h) | — | **−$1,159** |

Com o modelo da foto, a quantidade de madeira aparente cresceu (revestimento de 11 postes, 160 ripas 2x4). Por isso a economia do PT passa a ser real, **~$1,150 (11%)**, mesmo contando o stain e a segunda visita.

## Onde o PT é a melhor escolha

- **Postes embutidos:** PT *ground contact* (UC4B) é o material certo para ir enterrado. O cedro dura menos em contato com o solo e a umidade. **Nos dois cenários, os postes são PT.**
- **Núcleo dos postes** (escondido no revestimento): é mais barata e o SYP é mais rígido que o cedro (módulo de elasticidade ~1.6 contra ~1.1 milhão psi).
- **Cupim:** a região de Charlotte tem pressão alta de cupim subterrâneo, e o PT é resistente.

## Riscos do PT nas partes visíveis (ripas, vigas, caibros)

1. **Empenamento:** é o ponto que mais pesa, porque sua preocupação é deformação. O PT chega da loja **molhado** (umidade de 30%–60%) e, ao secar, encolhe, torce, encanoa e trinca bem mais que o cedro seco em estufa.
2. **Aparência:** tom esverdeado ou marrom no começo; fica cinza sem stain.
3. **Manutenção:** stain só depois de secar (1–3 meses; teste da gota d'água) e de novo a cada 2–3 anos. O cedro pode ficar natural e acinzentar com o tempo.
4. **Fixadores:** o tratamento com cobre corrói aço comum. Use galvanizado a fogo (G185) ou inox, como já está no orçamento.
5. **Cortes:** todo corte em PT, principalmente o pé dos postes, recebe preservativo (copper naphthenate). Já está incluído.

## Como reduzir a deformação se escolher PT

- Comprar **KDAT** (*kiln-dried after treatment*) ou deck board **premium**, e escolher as tábuas na loja: retas, com poucos nós e sem medula.
- **2 parafusos por apoio**, instalados com a madeira ainda úmida, para ela secar presa.
- No modelo atual a ripa é 2x4 deitado (1 1/2") em vão curto (19 3/8"), travada no serrilhado: é a configuração mais resistente a empeno. PT ripado (serrilhado de 2x6 ripado) tende a torcer mais: em PT, prefira 2x4 inteiro para o serrilhado.
- Guardar o material empilhado, com espaçadores, na sombra, até a instalação.

## Recomendação

- **Estrutura e postes: PT** (já é assim nos dois cenários).
- **Ripas e pergolado: cedro**, se o cliente aceita ~$1,150 a mais. Fica mais estável (menos empeno), não precisa de stain, dispensa a segunda visita e combina com a imagem conceito ("100% Natural Cedar, No Stain Needed").
- Se o orçamento do cliente for o fator decisivo, o PT funciona bem com os cuidados acima. Avise que pode haver algum empeno e que o stain é obrigatório.

_Preços online da Lowe's e da Home Depot (nov/2026), ainda não confirmados na loja de Cornelius. O PT 4x4x12, o PT 2x8x12 e o cedro 2x6 são estimados._
