Alfredobud/Handyman-project/projetos-madeira/clientes/bill/kitchen-privacy-screen/orcamento-c/comparativo-nucleo.md

# Opção C — comparativo de núcleo (7 postes, 8 ft, embutimento 36")

| Material | Núcleo | Vão livre | Poste | Núcleos (loja) | Materiais | Mão de obra | Total |
|---|---|---:|---:|---:|---:|---:|---:|
| Cedro (núcleo PT) | 4x4 | 3'-1 3/4" | 5 1/2" | $168 | $4,769 | $3,400 (57 h) | **$8,319** |
| Cedro (núcleo PT) | 4x6 | 3'-1 3/4" | 5 1/2" | $238 | $4,831 | $3,316 (55 h) | **$8,297** |
| Cedro (núcleo PT) | 6x6 | 3'-0" | 7" | $406 | $4,979 | $3,400 (57 h) | **$8,529** |
| 100% pinus | 4x4 | 3'-1 3/4" | 5 1/2" | $362 | $2,953 | $4,060 (68 h) | **$7,163** |
| 100% pinus | 4x6 | 3'-1 3/4" | 5 1/2" | $432 | $3,014 | $3,976 (66 h) | **$7,140** |
| 100% pinus | 6x6 | 3'-0" | 7" | $600 | $3,169 | $4,060 (68 h) | **$7,379** |
