Alfredobud/Handyman-project/projetos-madeira/clientes/bill/kitchen-privacy-screen/orcamento-rev9-1/opcao-b-pt/orcamento.md

# Orçamento — Kitchen Privacy Screen — 7 postes, 100% pinus tratado, núcleo 4x6

**Cliente:** Bill

## Resumo

| | Valor |
|---|---:|
| Materiais (subtotal loja) | $2,416.00 |
| Imposto sobre material (8.25%) | $199.32 |
| **Total materiais** | **$2,615.32** |
| Mão de obra (66.3 h × $60.00/h) | $3,976.20 |
| **Total mão de obra** | **$3,976.20** |
| **Taxa** | **$150.00** |
| **TOTAL** | **$6,741.52** |

## Lista de compra

| Material | Compr. | Qtd | Unit. | Subtotal | Obs. | Fonte do preço |
|---|---:|---:|---:|---:|---|---|
| Pinus tratado (PT SYP) 4x6 #2 ground contact UC4B | 12' | 7 | $34.00 | $238.00 |  | estimativa (conferir) |
| PT 5/4x6 premium SYP deck board | 16' | 8 | $19.00 | $152.00 | inclui 1 de sobra (5%) | referencia-media-big-box |
| PT 2x6 #2 Prime ground contact (WeatherShield) | 8' | 1 | $9.50 | $9.50 |  | referencia-media-big-box |
| PT 2x6 #2 Prime ground contact (WeatherShield) | 10' | 14 | $12.50 | $175.00 | inclui 1 de sobra (5%) | referencia-media-big-box |
| Pinus tratado 2x2 S4S | 8' | 76 | $5.00 | $380.00 | inclui 4 de sobra (5%) | estimativa (conferir) |
| PT 2x8 #2 Prime ground contact | 12' | 5 | $19.50 | $97.50 | inclui 1 de sobra (5%) | referencia-media-big-box (sem preço online local) |
| Concreto ensacado 80 lb (~0.60 cf) |  | 48 | $6.50 | $312.00 | saco — Furos Ø16" x 42" — concreto | referencia-media-big-box |
| Brita/cascalho ensacado 0.5 cf |  | 10 | $5.50 | $55.00 | saco — Brita | referencia-media-big-box |
| Aluguel mini skid steer (tipo Dingo) com auger 12in — 1 dia |  | 1 | $350.00 | $350.00 | dia — Locação mini skid steer + auger (1 dia) | estimativa locadora local (conferir) |
| Entrega/retirada do equipamento alugado |  | 1 | $100.00 | $100.00 | verba — Frete do equipamento | estimativa locadora local (conferir) |
| Preservativo para corte de PT (copper naphthenate) 1 qt |  | 1 | $22.00 | $22.00 | un — Preservativo nos cortes do PT | referencia-media-big-box |
| Parafuso passante galv. 1/2x8 + porca + arruelas |  | 28 | $4.50 | $126.00 | jogo — Parafusos passantes 1/2" (4 por poste) | referencia-media-big-box |
| Parafuso deck trim-head (cabeça pequena) revestido p/ PT/ACQ 2.5-3in (caixa 5 lb) |  | 4 | $42.00 | $168.00 | caixa — Parafusos deck trim-head | referencia-media-big-box |
| Cola PVA à prova d'água (Titebond III 8 oz) |  | 3 | $7.00 | $21.00 | un — Cola PU/exterior | referencia-media-big-box |
| Descarte de entulho / caçamba pequena |  | 1 | $75.00 | $75.00 | verba — Descarte | referencia-media-big-box |
| Stain/selador externo 1 gal (~250 sqft/demão) |  | 3 | $45.00 | $135.00 | galao — Stain (tudo, 1 demão após secagem) | referencia-media-big-box |

## Cálculos derivados

- **Furos Ø16" x 42" — concreto**: volume_cf = 28.36, sacos = 48

## Peças (lista de corte)

| Peça | Material | Qtd | Compr. (in) | Obs. |
|---|---|---:|---:|---|
| Núcleo 4x6 PT ground contact (embutir 36") | pt_4x6 | 7 | 129.5 |  |
| Laterais serrilhadas pt 5_4x6 | pt_5_4x6 | 12 | 89.5 |  |
| Laterais lisas pt 5_4x6 (pontas) | pt_5_4x6 | 2 | 89.5 |  |
| Faces pt 2x6 | pt_2x6 | 14 | 82.25 |  |
| Ripas pt 2x2 (24/vão) | pt_2x2 | 144 | 39.5 |  |
| Vigas pt 2x8 11'-6 1/2" (entalhadas, parafusadas no núcleo) | pt_2x8 | 4 | 138.5 |  |
| Caibros pt 2x6 ponta nuvem (13) | pt_2x6 | 13 | 36 |  |

## Plano de corte (sem a sobra de perda)

| Material | Tábuas | Compr. | Cortes por tábua | Sobra/tábua (in) |
|---|---:|---:|---|---:|
| pt_4x6 | 7 | 12' | 1x 129.5" Núcleo 4x6 PT ground contact (embutir 36") | 14.5 |
| pt_5_4x6 | 6 | 16' | 2x 89.5" Laterais serrilhadas pt 5_4x6 | 12.88 |
| pt_5_4x6 | 1 | 16' | 2x 89.5" Laterais lisas pt 5_4x6 (pontas) | 12.88 |
| pt_2x6 | 13 | 10' | 1x 82.25" Faces pt 2x6 + 1x 36" Caibros pt 2x6 ponta nuvem (13) | 1.62 |
| pt_2x6 | 1 | 8' | 1x 82.25" Faces pt 2x6 | 13.75 |
| pt_2x2 | 72 | 8' | 2x 39.5" Ripas pt 2x2 (24/vão) | 16.88 |
| pt_2x8 | 4 | 12' | 1x 138.5" Vigas pt 2x8 11'-6 1/2" (entalhadas, parafusadas no núcleo) | 5.5 |

## Mão de obra

| Tarefa | Qtd | Unid. | h/unid. | Horas |
|---|---:|---|---:|---:|
| obra_assentar_poste | 7 | poste | 0.45 | 3.1 |
| obra_transporte_equipamento | 1 | verba | 1 | 1.0 |
| obra_nivelar_topo | 7 | poste | 0.15 | 1.1 |
| oficina_serrilhado | 12 | peca | 0.6 | 7.2 |
| oficina_corte | 158 | peca | 0.04 | 6.3 |
| oficina_tabua_topo | 4 | peca | 0.6 | 2.4 |
| oficina_caibro_nuvem | 13 | peca | 0.6 | 7.8 |
| acabamento_stain | 450 | sqft | 0.02 | 9.0 |
| locacao | 1 | verba | 1 | 1.0 |
| obra_escavacao_mecanizada | 7 | furo | 0.15 | 1.1 |
| compras_transporte | 1 | verba | 3 | 3.0 |
| oficina_gabaritos | 1 | verba | 2 | 2.0 |
| oficina_acabamento_lixa | 189 | peca | 0.03 | 5.7 |
| obra_instalar_serrilhado | 12 | peca | 0.08 | 1.0 |
| obra_instalar_ripa | 144 | peca | 0.025 | 3.6 |
| obra_instalar_face | 14 | peca | 0.08 | 1.1 |
| obra_instalar_lateral | 2 | peca | 1 | 2.0 |
| obra_instalar_tabua_topo | 4 | peca | 0.5 | 2.0 |
| obra_instalar_caibro | 13 | peca | 0.15 | 1.9 |
| limpeza | 1 | verba | 2 | 2.0 |
| Retorno para stain após secagem | 2 | h | 1 | 2.0 |
| **Total** | | | | **66.3** |

## Premissas

- Comparativo de núcleo 4x6; vão livre 3'-1 3/4"; poste 5 1/2".

## Fontes de preço

- estimativa (conferir) (2026-11)
- estimativa (sem preço online local; conferir) (2026-11)
- estimativa locadora local (conferir) (2026-11)
- estimativa proporcional ao 10' da Lowe's (sem preço online) (2026-11)
- estimativa proporcional ao 12' da Lowe's (conferir) (2026-11)
- estimativa proporcional ao 2x8x12 da Lowe's (conferir) (2026-11)
- homedepot.com online $199 (2026-11; conferir loja Cornelius) (2026-11)
- homedepot.com online (S1S2E; nao confirmado) (2026-11)
- homedepot.com online (nao confirmado loja Cornelius) (2026-11)
- lowes.com online (nao confirmado loja Cornelius) (2026-11)
- referencia-media-big-box (2026-11)
- referencia-media-big-box (sem preço online local) (2026-11)
- walmart.com online $42.57-43.99 (2026-11; conferir) (2026-11)

_Preços de referência devem ser confirmados na loja/região antes da proposta final. Dimensionamento estrutural, licença/HOA, utilidades subterrâneas (811) e especificações do fabricante devem ser verificados antes da obra._
