Alfredobud/Handyman-project/projetos-madeira/clientes/bill/kitchen-privacy-screen/orcamento-7-postes/orcamento.md

# Orçamento — Kitchen Privacy Screen — 7 postes, 100% pinus autoclavado (PT), topo pergolado (Cornelius, NC)

**Cliente:** Bill

## Resumo

| | Valor |
|---|---:|
| Materiais (subtotal loja) | $1,871.36 |
| Imposto sobre material (8.25%) | $154.39 |
| **Total materiais** | **$2,025.75** |
| Mão de obra (61.8 h × $60.00/h) | $3,705.00 |
| **Total mão de obra** | **$3,705.00** |
| **Taxa** | **$150.00** |
| **TOTAL** | **$5,880.75** |

## Lista de compra

| Material | Compr. | Qtd | Unit. | Subtotal | Obs. | Fonte do preço |
|---|---:|---:|---:|---:|---|---|
| Pinus tratado (PT SYP) 4x4 #2 ground contact UC4B | 10' | 7 | $19.00 | $133.00 |  | referencia-media-big-box |
| PT 5/4x6 premium SYP deck board | 16' | 8 | $19.00 | $152.00 | inclui 1 de sobra (5%) | referencia-media-big-box |
| PT 2x4 #2 Prime ground contact (WeatherShield) | 10' | 34 | $8.88 | $301.92 | inclui 2 de sobra (5%) | homedepot.com online (nao confirmado loja Cornelius) |
| PT 2x6 #2 Prime ground contact (WeatherShield) | 8' | 7 | $9.50 | $66.50 |  | referencia-media-big-box |
| PT 2x6 #2 Prime ground contact (WeatherShield) | 12' | 8 | $14.18 | $113.44 | inclui 1 de sobra (5%) | homedepot.com online (nao confirmado loja Cornelius) |
| PT 2x8 #2 Prime ground contact | 8' | 6 | $13.00 | $78.00 | inclui 1 de sobra (5%) | referencia-media-big-box |
| PT 2x8 #2 Prime ground contact | 10' | 1 | $16.00 | $16.00 |  | referencia-media-big-box |
| Concreto ensacado 80 lb (~0.60 cf) |  | 18 | $6.50 | $117.00 | saco — Furos Ø12" x 30" — concreto em volta do núcleo | referencia-media-big-box |
| Brita/cascalho ensacado 0.5 cf |  | 6 | $5.50 | $33.00 | saco — Brita 6" no fundo dos furos | referencia-media-big-box |
| Aluguel mini skid steer (tipo Dingo) com auger 12in — 1 dia |  | 1 | $350.00 | $350.00 | dia — Locação: mini skid steer com auger 12" (1 dia) | estimativa locadora local (conferir) |
| Entrega/retirada do equipamento alugado |  | 1 | $100.00 | $100.00 | verba — Entrega/retirada do equipamento | estimativa locadora local (conferir) |
| Preservativo para corte de PT (copper naphthenate) 1 qt |  | 1 | $22.00 | $22.00 | un — Preservativo nos cortes do PT | referencia-media-big-box |
| Parafuso passante galv. 1/2x8 + porca + arruelas |  | 7 | $4.50 | $31.50 | jogo — Parafusos passantes 1/2"x10" (tábuas de topo/núcleo) | referencia-media-big-box |
| Parafuso deck trim-head (cabeça pequena) revestido p/ PT/ACQ 2.5-3in (caixa 5 lb) |  | 3 | $42.00 | $126.00 | caixa — Parafusos de deck trim-head (cabeça pequena, oculta), revestidos p/ PT | referencia-media-big-box |
| Cola PVA à prova d'água (Titebond III 8 oz) |  | 3 | $7.00 | $21.00 | un — Cola PU/exterior | referencia-media-big-box |
| Descarte de entulho / caçamba pequena |  | 1 | $75.00 | $75.00 | verba — Descarte | referencia-media-big-box |
| Stain/selador externo 1 gal (~250 sqft/demão) |  | 3 | $45.00 | $135.00 | galao — Stain semi-transparente (tudo, 1 demão após secagem) | referencia-media-big-box |

## Cálculos derivados

- **Furos Ø12" x 30" — concreto em volta do núcleo**: volume_cf = 10.34, sacos = 18

## Peças (lista de corte)

| Peça | Material | Qtd | Compr. (in) | Obs. |
|---|---|---:|---:|---|
| Núcleo PT 4x4 ground contact (embutir 24", nivelar topo na obra) | pt_4x4 | 7 | 117.5 |  |
| Laterais serrilhadas PT 5/4x6 (1", ripar p/ 3 1/2", 16 encaixes) | pt_5_4x6 | 12 | 89.5 |  |
| Ripas PT 2x4 deitado (16/vão x 6 vãos) | pt_2x4 | 96 | 39.5 |  |
| Faces do poste PT 2x6 (casa + vizinho) | pt_2x6 | 14 | 89.5 |  |
| Laterais lisas PT 5/4x6 (1", ripar p/ 3 1/2") — postes 1 e 7 | pt_5_4x6 | 2 | 89.5 |  |
| Tábuas de topo PT 2x8 de 7'-2 1/2", entalhadas p/ caibros (emendas sobre postes 3, 5) | pt_2x8 | 2 | 86.5 |  |
| Tábuas de topo PT 2x8 de 7'-11 1/4", entalhadas p/ caibros (emendas sobre postes 3, 5) | pt_2x8 | 4 | 95.25 |  |
| Fechamento das pontas das tábuas de topo PT 2x8 | pt_2x8 | 2 | 9.5 |  |
| Caibros do pergolado PT 2x6 com ponta tipo nuvem (1 por poste) | pt_2x6 | 7 | 36 |  |

## Plano de corte (sem a sobra de perda)

| Material | Tábuas | Compr. | Cortes por tábua | Sobra/tábua (in) |
|---|---:|---:|---|---:|
| pt_4x4 | 7 | 10' | 1x 117.5" Núcleo PT 4x4 ground contact (embutir 24", nivelar topo na obra) | 2.5 |
| pt_5_4x6 | 6 | 16' | 2x 89.5" Laterais serrilhadas PT 5/4x6 (1", ripar p/ 3 1/2", 16 encaixes) | 12.88 |
| pt_5_4x6 | 1 | 16' | 2x 89.5" Laterais lisas PT 5/4x6 (1", ripar p/ 3 1/2") — postes 1 e 7 | 12.88 |
| pt_2x4 | 32 | 10' | 3x 39.5" Ripas PT 2x4 deitado (16/vão x 6 vãos) | 1.25 |
| pt_2x6 | 7 | 12' | 1x 89.5" Faces do poste PT 2x6 (casa + vizinho) + 1x 36" Caibros do pergolado PT 2x6 com ponta tipo nuvem (1 por poste) | 18.38 |
| pt_2x6 | 7 | 8' | 1x 89.5" Faces do poste PT 2x6 (casa + vizinho) | 6.5 |
| pt_2x8 | 1 | 10' | 1x 95.25" Tábuas de topo PT 2x8 de 7'-11 1/4", entalhadas p/ caibros (emendas sobre postes 3, 5) + 2x 9.5" Fechamento das pontas das tábuas de topo PT 2x8 | 5.5 |
| pt_2x8 | 3 | 8' | 1x 95.25" Tábuas de topo PT 2x8 de 7'-11 1/4", entalhadas p/ caibros (emendas sobre postes 3, 5) | 0.75 |
| pt_2x8 | 2 | 8' | 1x 86.5" Tábuas de topo PT 2x8 de 7'-2 1/2", entalhadas p/ caibros (emendas sobre postes 3, 5) | 9.5 |

## Mão de obra

| Tarefa | Qtd | Unid. | h/unid. | Horas |
|---|---:|---|---:|---:|
| obra_assentar_poste | 7 | poste | 0.45 | 3.1 |
| obra_transporte_equipamento | 1 | verba | 1 | 1.0 |
| obra_nivelar_topo | 7 | poste | 0.15 | 1.1 |
| oficina_serrilhado | 12 | peca | 0.6 | 7.2 |
| oficina_corte | 110 | peca | 0.04 | 4.4 |
| oficina_ripar | 14 | peca | 0.1 | 1.4 |
| oficina_tabua_topo | 6 | peca | 0.6 | 3.6 |
| oficina_fechamento | 2 | peca | 0.25 | 0.5 |
| oficina_caibro_nuvem | 7 | peca | 0.6 | 4.2 |
| acabamento_stain | 450 | sqft | 0.02 | 9.0 |
| locacao | 1 | verba | 1 | 1.0 |
| obra_escavacao_mecanizada | 7 | furo | 0.15 | 1.1 |
| compras_transporte | 1 | verba | 3 | 3.0 |
| oficina_gabaritos | 1 | verba | 2 | 2.0 |
| oficina_acabamento_lixa | 139 | peca | 0.03 | 4.2 |
| obra_instalar_serrilhado | 12 | peca | 0.08 | 1.0 |
| obra_instalar_ripa | 96 | peca | 0.025 | 2.4 |
| obra_instalar_face | 14 | peca | 0.08 | 1.1 |
| obra_instalar_lateral | 2 | peca | 1 | 2.0 |
| obra_instalar_tabua_topo | 6 | peca | 0.5 | 3.0 |
| obra_instalar_fechamento | 2 | peca | 0.25 | 0.5 |
| obra_instalar_caibro | 7 | peca | 0.15 | 1.1 |
| limpeza | 1 | verba | 2 | 2.0 |
| Visita de retorno para stain após secagem da madeira | 2 | h | 1 | 2.0 |
| **Total** | | | | **61.8** |

## Premissas

- Material: 100% pinus autoclavado (PT). Stain em 2ª visita após a secagem.
- 7 postes a 3'-7 1/4" entre eixos; vão livre 3'-1 3/4"; vão/poste = 6.86 ≈ φ⁴ (89/13 de Fibonacci); acima do limite conservador de 36" (ainda abaixo do máximo de 48"): ripa 2x4 deitada aguenta, mas tem mais chance de arquear do que com 10 postes.
- Poste composto: núcleo PT 4x4 ground contact embutido 24" em concreto (furo Ø12" x 30", 6" de brita), furos com mini skid steer + auger alugado. Revestimento acima do colar: faces 2x6 e laterais de 1" (serrilhadas nos vãos, lisas nas pontas); todos os postes com 5 1/2", faces alinhadas.
- Ripas 2x4 deitadas: 16 por vão, espaço 1 11/16", ripa de 3'-3 1/2"; instaladas pelo lado do vizinho.
- Topo: tábuas 2x8 dos dois lados dos postes, entalhadas 1 1/2" para os caibros, 3 peças por lado (7'-11 1/4" + 7'-2 1/2" + 7'-11 1/4") com emendas sobre os postes 3, 5; fechamento de 9 1/2" nas pontas (aparência de viga maciça); 7 caibros 2x6 de 36" com ponta tipo nuvem.
- Acabamento da madeira: todo cedro aparente Western Red Cedar seco em estufa (KD), APLAINADO S4S (medidas reais 2x4 = 1 1/2 x 3 1/2, 2x6 = 1 1/2 x 5 1/2, 2x8 = 1 1/2 x 7 1/4, 5/4x6 = 1 x 5 1/2). Na Lowe's o cedro 2x6/2x8 costuma ser BRUTO/green (~1 11/16 x 5 3/4 e 7 5/8): comprar S4S em madeireira ou aplainar na oficina; os núcleos dos postes são pinus tratado (PT SYP) ground contact.
- Fixação: parafusos de deck trim-head (cabeça pequena, fica oculta), revestidos para PT/ACQ (não inox); parafuso passante de 1/2" nas tábuas de topo.
- Mão de obra separada em OFICINA (pré-corte: serrilhados, ripas, faces, laterais, tábuas de topo, fechamentos, caibros, gabaritos, lixa) e OBRA (furos, postes, nivelamento, montagem).
- Sequência de instalação (A-3): 1 furos, 2 postes, 3 nivelar topos, 4 serrilhados pelo lado do vizinho, 5 ripas, 6 fechamento frontal, 7 fechamento lateral, 8 tábuas de topo, 9 fechamento das pontas, 10 caibros do pergolado.
- Preços: Lowe's/Home Depot online (nov/2026) e estimativas marcadas na coluna de fonte (PT 4x4x12, cedro 2x6/2x8, locação do equipamento, parafuso trim-head); confirmar em Cornelius.
- Imposto de Mecklenburg de 8.25% sobre o material; sem markup e sem contingência; taxa fixa de $150.
- Paisagismo (manta, borda e pedra de rio) NÃO incluído: é extra opcional, cotado à parte na proposta; trepadeiras não incluídas.
- Produtividade revisada com o ritmo real da equipe: furos + postes em 1 dia; serrilhados, ripas e faces chegam prontos e só encaixam.

## Perguntas / verificações de campo

- [ ] Confirmar preço e disponibilidade do mini skid steer com auger (Home Depot Rental / Sunbelt / United Rentals na região).
- [ ] Confirmar na loja os preços do cedro 2x6, 2x8 e 5/4x6 e do PT 4x4.
- [ ] NC811 antes de escavar; licença/HOA de Cornelius; posição da divisa.
- [ ] Trepadeiras e canteiro: o cliente fornece ou incluímos?

## Fontes de preço

- estimativa (sem preço online local; conferir) (2026-11)
- estimativa locadora local (conferir) (2026-11)
- estimativa proporcional ao 10' da Lowe's (sem preço online) (2026-11)
- estimativa proporcional ao 12' da Lowe's (conferir) (2026-11)
- estimativa proporcional ao 2x8x12 da Lowe's (conferir) (2026-11)
- homedepot.com online (nao confirmado loja Cornelius) (2026-11)
- lowes.com online (nao confirmado loja Cornelius) (2026-11)
- referencia-media-big-box (2026-11)
- referencia-media-big-box (sem preço online local) (2026-11)

_Preços de referência devem ser confirmados na loja/região antes da proposta final. Dimensionamento estrutural, licença/HOA, utilidades subterrâneas (811) e especificações do fabricante devem ser verificados antes da obra._
