Alfredobud/Handyman-project/projetos-madeira/clientes/bill/kitchen-privacy-screen/orcamento-rev9-1/opcao-b-pt/orcamento.xlsx

Sheet: Resumo
Projeto | Kitchen Privacy Screen — 7 postes, 100% pinus tratado, núcleo 4x6
Cliente | Bill
material_subtotal | 2416
material_imposto | 199.32
material_markup | 0
material_contingencia | 0
material_total | 2615.32
horas | 66.3
mao_de_obra_subtotal | 3976.2
mao_de_obra_contingencia | 0
mao_de_obra_total | 3976.2
taxa_fixa | 150
total_geral | 6741.52

Sheet: Compra
Material | Descrição | Compr. (ft) | Qtd | Unit. USD | Subtotal USD | Obs. | Fonte
pt_4x6 | Pinus tratado (PT SYP) 4x6 #2 ground contact UC4B | 12 | 7 | 34 | 238 |  | estimativa (conferir)
pt_5_4x6 | PT 5/4x6 premium SYP deck board | 16 | 8 | 19 | 152 | inclui 1 de sobra (5%) | referencia-media-big-box
pt_2x6 | PT 2x6 #2 Prime ground contact (WeatherShield) | 8 | 1 | 9.5 | 9.5 |  | referencia-media-big-box
pt_2x6 | PT 2x6 #2 Prime ground contact (WeatherShield) | 10 | 14 | 12.5 | 175 | inclui 1 de sobra (5%) | referencia-media-big-box
pt_2x2 | Pinus tratado 2x2 S4S | 8 | 76 | 5 | 380 | inclui 4 de sobra (5%) | estimativa (conferir)
pt_2x8 | PT 2x8 #2 Prime ground contact | 12 | 5 | 19.5 | 97.5 | inclui 1 de sobra (5%) | referencia-media-big-box (sem preço online local)
concreto_80lb | Concreto ensacado 80 lb (~0.60 cf) |  | 48 | 6.5 | 312 | saco — Furos Ø16" x 42" — concreto | referencia-media-big-box
brita_saco | Brita/cascalho ensacado 0.5 cf |  | 10 | 5.5 | 55 | saco — Brita | referencia-media-big-box
aluguel_mini_skid_auger | Aluguel mini skid steer (tipo Dingo) com auger 12in — 1 dia |  | 1 | 350 | 350 | dia — Locação mini skid steer + auger (1 dia) | estimativa locadora local (conferir)
frete_equipamento | Entrega/retirada do equipamento alugado |  | 1 | 100 | 100 | verba — Frete do equipamento | estimativa locadora local (conferir)
preservativo_corte | Preservativo para corte de PT (copper naphthenate) 1 qt |  | 1 | 22 | 22 | un — Preservativo nos cortes do PT | referencia-media-big-box
parafuso_passante | Parafuso passante galv. 1/2x8 + porca + arruelas |  | 28 | 4.5 | 126 | jogo — Parafusos passantes 1/2" (4 por poste) | referencia-media-big-box
parafuso_deck_trim | Parafuso deck trim-head (cabeça pequena) revestido p/ PT/ACQ 2.5-3in (caixa 5 lb) |  | 4 | 42 | 168 | caixa — Parafusos deck trim-head | referencia-media-big-box
cola_externa | Cola PVA à prova d'água (Titebond III 8 oz) |  | 3 | 7 | 21 | un — Cola PU/exterior | referencia-media-big-box
descarte | Descarte de entulho / caçamba pequena |  | 1 | 75 | 75 | verba — Descarte | referencia-media-big-box
stain_galao | Stain/selador externo 1 gal (~250 sqft/demão) |  | 3 | 45 | 135 | galao — Stain (tudo, 1 demão após secagem) | referencia-media-big-box

Sheet: Cortes
Material | Qtd tábuas | Compr. (ft) | Cortes por tábua | Sobra/tábua (in)
pt_4x6 | 7 | 12 | 1x 129.5" Núcleo 4x6 PT ground contact (embutir 36") | 14.5
pt_5_4x6 | 6 | 16 | 2x 89.5" Laterais serrilhadas pt 5_4x6 | 12.88
pt_5_4x6 | 1 | 16 | 2x 89.5" Laterais lisas pt 5_4x6 (pontas) | 12.88
pt_2x6 | 13 | 10 | 1x 82.25" Faces pt 2x6 + 1x 36" Caibros pt 2x6 ponta nuvem (13) | 1.62
pt_2x6 | 1 | 8 | 1x 82.25" Faces pt 2x6 | 13.75
pt_2x2 | 72 | 8 | 2x 39.5" Ripas pt 2x2 (24/vão) | 16.88
pt_2x8 | 4 | 12 | 1x 138.5" Vigas pt 2x8 11'-6 1/2" (entalhadas, parafusadas no núcleo) | 5.5

Sheet: Mão de obra
Tarefa | Qtd | Unid. | h/unid. | Horas
obra_assentar_poste | 7 | poste | 0.45 | 3.15
obra_transporte_equipamento | 1 | verba | 1 | 1
obra_nivelar_topo | 7 | poste | 0.15 | 1.05
oficina_serrilhado | 12 | peca | 0.6 | 7.2
oficina_corte | 158 | peca | 0.04 | 6.32
oficina_tabua_topo | 4 | peca | 0.6 | 2.4
oficina_caibro_nuvem | 13 | peca | 0.6 | 7.8
acabamento_stain | 450 | sqft | 0.02 | 9
locacao | 1 | verba | 1 | 1
obra_escavacao_mecanizada | 7 | furo | 0.15 | 1.05
compras_transporte | 1 | verba | 3 | 3
oficina_gabaritos | 1 | verba | 2 | 2
oficina_acabamento_lixa | 189 | peca | 0.03 | 5.67
obra_instalar_serrilhado | 12 | peca | 0.08 | 0.96
obra_instalar_ripa | 144 | peca | 0.025 | 3.6
obra_instalar_face | 14 | peca | 0.08 | 1.12
obra_instalar_lateral | 2 | peca | 1 | 2
obra_instalar_tabua_topo | 4 | peca | 0.5 | 2
obra_instalar_caibro | 13 | peca | 0.15 | 1.95
limpeza | 1 | verba | 2 | 2
Retorno para stain após secagem | 2 | h | 1 | 2

Sheet: Premissas
Premissas e perguntas
Comparativo de núcleo 4x6; vão livre 3'-1 3/4"; poste 5 1/2".
