Alfredobud/Handyman-project/projetos-madeira/clientes/teste1/cerca-trancada/orcamento-modulo/precos.csv

id | descricao | unidade | comprimento_ft | preco_usd | fonte | data
pt_1x6 | Pinus tratado 1x6 S4S (tábua de cerca/aparência) | peca | 8 | 7.00 | estimativa (conferir loja) | 2026-11
pt_1x6 | Pinus tratado 1x6 S4S (tábua de cerca/aparência) | peca | 10 | 9.00 | estimativa (conferir loja) | 2026-11
pt_1x6 | Pinus tratado 1x6 S4S (tábua de cerca/aparência) | peca | 12 | 11.00 | estimativa (conferir loja) | 2026-11
pt_1x2 | Pinus tratado 1x2 S4S | peca | 8 | 3.00 | estimativa (conferir loja) | 2026-11
pt_2x4 | PT 2x4 #2 Prime ground contact S4S | peca | 10 | 8.88 | homedepot.com online (Cornelius nao confirmado) | 2026-11
pt_6x6 | Pinus tratado 6x6 #2 ground contact UC4B S4S | peca | 8 | 38.00 | referencia-media-big-box (conferir) | 2026-11
aluguel_mini_skid_auger | Aluguel mini skid steer com auger 12in — 1 dia | dia |  | 350.00 | estimativa locadora local (conferir) | 2026-11
frete_equipamento | Entrega/retirada do equipamento alugado | verba |  | 100.00 | estimativa locadora local (conferir) | 2026-11
parafuso_deck_trim | Parafuso deck trim-head revestido p/ PT/ACQ (caixa 5 lb) | caixa |  | 42.00 | referencia-media-big-box | 2026-11
cedro_5_8x6 | Cedro 5/8 x 6 S4S (tábua de cerca longa) | peca | 10 | 15.00 | estimativa (10' em 5/8 pode exigir madeireira; conferir) | 2026-11
prego_pneumatico_inox | Prego pneumático inox anelado 2in p/ cedro (caixa ~1000) | caixa |  | 48.00 | estimativa (conferir) | 2026-11
tinta_pistola | Stain/tinta sólida exterior p/ pistola 1 gal (~200 sqft/gal na pistola) | galao |  | 48.00 | estimativa (conferir) | 2026-11
parafuso_estrutural_caixa | Parafuso estrutural 3-4in (caixa 50) | caixa |  | 48.00 | referencia-media-big-box | 2026-11
