Alfredobud/Handyman-project/(list of files, cad)

Other CAD files:
projetos-madeira/clientes/bill/kitchen-privacy-screen/desenhos/arquivo-rev7/10-postes/privacy-screen.dxf
projetos-madeira/clientes/bill/kitchen-privacy-screen/desenhos/arquivo-rev7/7-postes/privacy-screen.dxf
projetos-madeira/clientes/bill/kitchen-privacy-screen/desenhos/rev9-a-cedro/privacy-screen.dxf
projetos-madeira/clientes/bill/kitchen-privacy-screen/desenhos/rev9-b-pinus/privacy-screen.dxf
projetos-madeira/kitchen-privacy-screen/desenhos/privacy-screen.dxf
projetos-madeira/kitchen-privacy-screen/desenhos/pt/privacy-screen.dxf
