Alfredobud/Handyman-project/projetos-madeira/clientes/teste1/cerca-trancada/README.md

# Cerca trançada — cliente teste1

**Status:** rev. 2: painel pré-fabricado com **tábuas de cedro 5/8"**, prego pneumático nas ripas, parafuso nos postes e pintura com pistola. Orçamento preliminar refeito; prévias P-1, P-2 e P-3 (sem PDF final).
**Referência:** [`referencias/referencia-cerca-trancada.jpg`](referencias/referencia-cerca-trancada.jpg): cerca horizontal trançada (tábuas passam na frente e atrás de sarrafos verticais), com capeamento e LED.

## Premissas do módulo (rev. 0)
| Item | Definição |
|---|---|
| Trechos | laterais de 40' + fundo de 60' (em "U", aberto para a casa) |
| Módulo | **10'-0" entre eixos (3.05 m)**: o único entre 2.5 e 3 m que divide 40' e 60' exatamente → 4 + 6 + 4 = **14 módulos iguais, 15 postes** |
| Altura | **6'-1 1/2"** → módulo/altura = 1.633 ≈ φ (1.618) |
| Folga do terreno | 3" sob a travessa inferior |
| Postes | pinus tratado 6x6 ground contact, 8', embutidos 24" em concreto (furo Ø12") sobre 6" de brita |
| **Painel (oficina)** | moldura **fechada nos 4 cantos**, em 2x4 S4S (3 1/2" na espessura), todas as peças com rasgo de 2 1/4" x 3/4"; montantes inteiros de 5'-9" e travessas de 9'-3" entre eles; cantos com cola PU + 2 parafusos estruturais |
| Painel: medidas | **9'-6" x 5'-9"** (folga de 1/4" de cada lado do vão de 9'-6 1/2"); ~126 lb com cedro 5/8" |
| Trançado | 12 tábuas de **cedro 5/8" x 6** de 9'-4 1/4" nos rasgos (agora de 2") dos montantes, com **prego pneumático inox** em cada cruzamento; 3 sarrafos 1x2 PT de 5'-7 1/4" |
| Montagem do painel | rasgar as 4 peças → "U" (travessa inferior + montantes) → sarrafos → trançar as tábuas → travessa superior (4º canto) |
| Instalação | blocos de apoio 2x4 nos postes (folga de 3") → batentes 1x2 do lado do vizinho → painel encaixado pelo lado da casa → batentes do lado da casa → capeamento 2x6 contínuo (painel removível) |
| Estrutura | travessa 2x4 inferior e superior, capeamento 2x6 contínuo |
| Material | tábuas de cedro 5/8"; estrutura (postes, moldura KDAT, sarrafos, batentes, capa) em pinus tratado S4S; sem composite |
| Acabamento | **pintura com pistola**: painéis na oficina; postes e capa na obra (retorno após secagem do PT) |
| Fixação nos postes | **parafusos** (batentes, blocos de apoio, capa) |

## Orçamento preliminar (rev. 2, painel pré-fabricado)
| | Materiais | Mão de obra | Total |
|---|---:|---:|---:|
| [1 painel + 1 poste](orcamento-modulo/orcamento.md) (sem mobilização) | $581 | $397 (6.6 h) | $1,128 |
| [Cerca completa, 140 ft](orcamento-completo/orcamento.md) (14 painéis, 15 postes) | $6,308 | $6,543 (109 h: oficina 59.7 h + obra 49.3 h) | **$13,001** (~$929/painel) |

Maior item: cedro 5/8" x 6 x 10' (177 tábuas, ~$2,655 a $15 estimado). Specs gerados por `gerar_specs.py`.

## A definir
- [ ] Altura: 6'-1 1/2" pela proporção áurea; o HOA ou o código local limita a 6'-0"?
- [ ] Iluminação LED atrás das tábuas (como na foto)?
- [ ] Portões: quantos e onde?
- [ ] Terreno plano ou com desnível (escalonar os módulos)?
- [x] Pintura: pistola
- [x] Tábua: cedro 5/8" (painel ~126 lb)
- [ ] Cedro 5/8" em 10': disponibilidade e preço na madeireira
- [ ] Cor/produto da pintura
