Alfredobud/Handyman-project/projetos-madeira/clientes/teste1/cerca-trancada/orcamento-completo/orcamento.md

# Orçamento — Cerca trançada — estudo de 1 módulo (cliente teste1)

**Cliente:** teste1

## Resumo

| | Valor |
|---|---:|
| Materiais (subtotal loja) | $5,827.52 |
| Imposto sobre material (8.25%) | $480.77 |
| **Total materiais** | **$6,308.29** |
| Mão de obra (109 h × $60.00/h) | $6,542.52 |
| **Total mão de obra** | **$6,542.52** |
| **Taxa** | **$150.00** |
| **TOTAL** | **$13,000.81** |

## Lista de compra

| Material | Compr. | Qtd | Unit. | Subtotal | Obs. | Fonte do preço |
|---|---:|---:|---:|---:|---|---|
| Pinus tratado 6x6 #2 ground contact UC4B S4S | 8' | 15 | $38.00 | $570.00 |  | referencia-media-big-box (conferir) |
| PT 2x4 #2 Prime ground contact S4S | 10' | 29 | $8.88 | $257.52 | inclui 3 de sobra (5%) | homedepot.com online (Cornelius nao confirmado) |
| PT 2x4 #2 Prime ground contact S4S | 12' | 16 | $10.00 | $160.00 |  | referencia-media-big-box |
| Cedro 5/8 x 6 S4S (tábua de cerca longa) | 10' | 177 | $15.00 | $2,655.00 | inclui 9 de sobra (5%) | estimativa (10' em 5/8 pode exigir madeireira; conferir) |
| Pinus tratado 1x2 S4S | 8' | 103 | $3.00 | $309.00 | inclui 5 de sobra (5%) | estimativa (conferir loja) |
| PT 2x6 | 10' | 15 | $12.50 | $187.50 | inclui 1 de sobra (5%) | referencia-media-big-box |
| Concreto ensacado 80 lb (~0.60 cf) |  | 31 | $6.50 | $201.50 | saco — Furos Ø12" x 30" — concreto | referencia-media-big-box |
| Brita/cascalho ensacado 0.5 cf |  | 12 | $5.50 | $66.00 | saco — Brita no fundo dos furos | referencia-media-big-box |
| Prego pneumático inox anelado 2in p/ cedro (caixa ~1000) |  | 1 | $48.00 | $48.00 | caixa — Montagem do painel (U + sarrafos + trançado com prego pneumático + 4º canto) | estimativa (conferir) |
| Parafuso estrutural 3-4in (caixa 50) |  | 3 | $48.00 | $144.00 | caixa — Parafusos estruturais dos cantos da moldura (8/painel) + cola PU | referencia-media-big-box |
| Cola PVA à prova d'água (Titebond III 8 oz) |  | 4 | $7.00 | $28.00 | un — Cola PU exterior | referencia-media-big-box |
| Stain/tinta sólida exterior p/ pistola 1 gal (~200 sqft/gal na pistola) |  | 11 | $48.00 | $528.00 | galao — Pintura com pistola (painéis na oficina + postes/capa na obra) | estimativa (conferir) |
| Parafuso deck trim-head revestido p/ PT/ACQ (caixa 5 lb) |  | 3 | $42.00 | $126.00 | caixa — Parafusos trim-head nos postes (batentes, blocos, capa) | referencia-media-big-box |
| Aluguel mini skid steer com auger 12in — 1 dia |  | 1 | $350.00 | $350.00 | dia — Locação: mini skid steer com auger 12" (1 dia) | estimativa locadora local (conferir) |
| Entrega/retirada do equipamento alugado |  | 1 | $100.00 | $100.00 | verba — Entrega/retirada do equipamento | estimativa locadora local (conferir) |
| Preservativo para corte de PT (copper naphthenate) 1 qt |  | 1 | $22.00 | $22.00 | un — Preservativo nos cortes do PT | referencia-media-big-box |
| Descarte de entulho / caçamba pequena |  | 1 | $75.00 | $75.00 | verba — Descarte | referencia-media-big-box |

## Cálculos derivados

- **Furos Ø12" x 30" — concreto**: volume_cf = 18.19, sacos = 31

## Peças (lista de corte)

| Peça | Material | Qtd | Compr. (in) | Obs. |
|---|---|---:|---:|---|
| Postes pinus tratado 6x6 ground contact (embutir 24") | pt_6x6 | 15 | 96 |  |
| Moldura: montantes 2x4 PT S4S com rasgo (2/painel) | pt_2x4 | 28 | 69 |  |
| Moldura: travessas 2x4 PT S4S com rasgo (2/painel) | pt_2x4 | 28 | 111 |  |
| Tábuas trançadas cedro 5/8 x 6 (12/painel) | cedro_5_8x6 | 168 | 112.25 |  |
| Sarrafos do trançado 1x2 PT (3/painel) | pt_1x2 | 42 | 67.25 |  |
| Blocos de apoio 2x4 (2 por painel) | pt_2x4 | 28 | 3 |  |
| Batentes 1x2 PT nos postes (4 por painel) | pt_1x2 | 56 | 69 |  |
| Capeamento 2x6 PT contínuo (emenda sobre poste) | pt_2x6 | 14 | 120 |  |

## Plano de corte (sem a sobra de perda)

| Material | Tábuas | Compr. | Cortes por tábua | Sobra/tábua (in) |
|---|---:|---:|---|---:|
| pt_6x6 | 15 | 8' | 1x 96" Postes pinus tratado 6x6 ground contact (embutir 24") | 0 |
| pt_2x4 | 1 | 12' | 1x 111" Moldura: travessas 2x4 PT S4S com rasgo (2/painel) + 10x 3" Blocos de apoio 2x4 (2 por painel) | 1.75 |
| pt_2x4 | 1 | 12' | 1x 111" Moldura: travessas 2x4 PT S4S com rasgo (2/painel) + 4x 3" Blocos de apoio 2x4 (2 por painel) | 20.5 |
| pt_2x4 | 26 | 10' | 1x 111" Moldura: travessas 2x4 PT S4S com rasgo (2/painel) | 9 |
| pt_2x4 | 14 | 12' | 2x 69" Moldura: montantes 2x4 PT S4S com rasgo (2/painel) + 1x 3" Blocos de apoio 2x4 (2 por painel) | 2.75 |
| cedro_5_8x6 | 168 | 10' | 1x 112.25" Tábuas trançadas cedro 5/8 x 6 (12/painel) | 7.75 |
| pt_1x2 | 56 | 8' | 1x 69" Batentes 1x2 PT nos postes (4 por painel) | 27 |
| pt_1x2 | 42 | 8' | 1x 67.25" Sarrafos do trançado 1x2 PT (3/painel) | 28.75 |
| pt_2x6 | 14 | 10' | 1x 120" Capeamento 2x6 PT contínuo (emenda sobre poste) | 0 |

## Mão de obra

| Tarefa | Qtd | Unid. | h/unid. | Horas |
|---|---:|---|---:|---:|
| obra_assentar_poste | 15 | poste | 0.45 | 6.8 |
| obra_nivelar_topo | 15 | poste | 0.15 | 2.2 |
| oficina_rasgo_moldura | 56 | peca | 0.15 | 8.4 |
| oficina_corte | 308 | peca | 0.04 | 12.3 |
| oficina_montar_painel | 14 | painel | 1.25 | 17.5 |
| oficina_pintura_pistola | 1912 | sqft | 0.006 | 11.5 |
| obra_bloco_apoio | 28 | peca | 0.1 | 2.8 |
| obra_batente | 56 | peca | 0.08 | 4.5 |
| obra_capa | 14 | peca | 0.3 | 4.2 |
| obra_instalar_painel | 14 | painel | 0.75 | 10.5 |
| obra_transporte_equipamento | 1 | verba | 1 | 1.0 |
| obra_escavacao_mecanizada | 15 | furo | 0.15 | 2.2 |
| oficina_acabamento_lixa | 266 | peca | 0.03 | 8.0 |
| obra_pintura_pistola | 264 | sqft | 0.01 | 2.6 |
| locacao | 1 | verba | 1 | 1.0 |
| compras_transporte | 1 | verba | 3 | 3.0 |
| limpeza | 1 | verba | 2 | 2.0 |
| oficina_gabaritos | 1 | verba | 2 | 2.0 |
| obra_transporte_paineis | 3 | viagem | 1.5 | 4.5 |
| Retorno: pintura dos postes/capa após secagem do PT | 2 | h | 1 | 2.0 |
| **Total** | | | | **109.0** |

## Premissas

- Solução PAINEL PRÉ-FABRICADO: moldura fechada nos 4 cantos (9'-6" x 5'-9"), 2x4 PT S4S com rasgo de 2" x 3/4"; montada e pintada na oficina; ~126 lb por painel.
- Trançado: 12 tábuas de CEDRO 5/8" x 6 (9'-4 1/4") e 3 sarrafos 1x2 PT; tábuas fixadas com prego pneumático inox anelado em cada cruzamento com os sarrafos.
- Módulo de 10'-0" entre eixos: 40'/60'/40' = [4, 6, 4] → 14 painéis iguais e 15 postes 6x6 PT ground contact de 8', embutidos 24" em concreto sobre 6" de brita (furos com mini skid steer + auger alugado).
- Altura total 6'-1 1/2" (módulo/altura = 1.633 ≈ φ); folga de 3" do terreno, definida pelos blocos de apoio.
- Instalação: blocos de apoio → batentes 1x2 do lado do vizinho → painel → batentes do lado da casa → capeamento 2x6. Nos postes, tudo com PARAFUSO (batentes, blocos e capa).
- Pintura com PISTOLA: painéis na oficina (2 faces, +25% pelo relevo do trançado); postes e capa na obra, numa visita de retorno depois da secagem do PT. Rendimento adotado de ~200 sqft/gal na pistola.
- Estrutura (moldura, sarrafos, batentes, capa, postes) em pinus tratado S4S; usar KDAT na moldura para poder pintar logo.
- PRELIMINAR: preços de cedro 5/8 em 10', 1x2, 6x6, pregos e tinta são estimados.
- Inclui locação do equipamento, transporte dos painéis (reboque), mobilização, compras, limpeza e retorno da pintura.

## Perguntas / verificações de campo

- [ ] Cedro 5/8" em 10': confirmar disponibilidade (madeireira) e preço.
- [ ] Cor/produto da pintura (stain transparente, semi ou sólido)?
- [ ] Altura 6'-1 1/2": confirmar limite de HOA/código.
- [ ] LED, portões, desnível do terreno.

## Fontes de preço

- estimativa (10' em 5/8 pode exigir madeireira; conferir) (2026-11)
- estimativa (conferir loja) (2026-11)
- estimativa (conferir) (2026-11)
- estimativa locadora local (conferir) (2026-11)
- homedepot.com online (Cornelius nao confirmado) (2026-11)
- referencia-lowes-online (2026-11)
- referencia-media-big-box (2026-11)
- referencia-media-big-box (conferir) (2026-11)

_Preços de referência devem ser confirmados na loja/região antes da proposta final. Dimensionamento estrutural, licença/HOA, utilidades subterrâneas (811) e especificações do fabricante devem ser verificados antes da obra._
