Alfredobud/Handyman-project/(commit log)

2026-11-10 Add orcamento-madeira skill and preliminary privacy screen quote
    - Skill .claude/skills/orcamento-madeira: workflow for quoting wood projects
    from photos/PDFs, cut optimizer script (stock lengths, kerf, ripping,
    nested parts), reference price and labor-rate catalogs, photo scale
    guide, construction rules of thumb, client proposal template
    - Evals: privacy screen packet + two Adirondack chair plans
    - Kitchen privacy screen: spec.json and generated quote (md/xlsx/json)
    - Adirondack chair reference plans
    Claude-Session: https://claude.ai/code/session_01CiNmhbRgwgqVtfDXxh5L53
    [orcamento.xlsx]
2026-11-10 Requote privacy screen in wood with Cornelius NC prices; fixed fee option
    - Quote: cedar 5/4x6 slats with mid-bay support, cedar pergola, PT structure;
    Lowe's/Home Depot online prices, 8.25% Mecklenburg sales tax, $60/h,
    no material markup or contingency, flat $150 fee
    - Script: taxa_fixa_usd parameter, per-line price source in shopping list
    - Rules: prefer 5/4 boards and mid supports when warping is a concern
    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
    [orcamento.xlsx, precos.csv]
2026-11-10 Add desenho-madeira skill; privacy screen drawings, buried posts and PT analysis
    - New skill .claude/skills/desenho-madeira: 2D CAD-style sheet library
    (cad.py: views, dimensions, hatches, leaders, title block; SVG/PDF/DXF
    export) and privacy_screen template driven by spec.json geometria
    - Privacy screen rev 0 drawings: A-1 elevation + plan, A-2 section A-A,
    footing, horizontal section, rafter end detail, parts list
    - Posts now PT ground contact embedded 36in in concrete over gravel
    (12ft posts, no post bases); quote updated
    - New all-PT scenario (orcamento-pt) and PT vs cedar analysis
    Claude-Session: https://claude.ai/code/ses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
    [orcamento.xlsx, precos.csv, privacy-screen.dxf]
2026-11-10 Privacy screen rev 2: match reference image, composite post with notched side boards
    - Template rewritten: 11 posts, composite post (PT 4x4 core embedded 36in +
    2x6 faces + notched 2x6 side boards that hold the 2x4 slats), cloud-lift
    rafter ends one per post, exposed concrete collar, landscaping in plan,
    side elevation; new sheet A-3 with post section, notch detail and
    assembly sequence
    - Both quotes rebuilt for the new design (cedar ~10.2k, all-PT ~9.1k)
    - New labor rates: revestimento_poste, serrilhado, ripa_encaixe, caibro_nuvem
    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
    [orcamento.xlsx, precos.csv, privacy-screen.dxf]
2026-11-10 Privacy screen rev 3: 1in notched side boards on intermediate posts
    - Intermediate posts: 3.5 core + 1in notched boards = 5.5in, flush with the
    2x6 faces; end posts keep a 1.5in plain 2x6 on the outer side (6in)
    - Template supports per-post widths; A-3 shows intermediate and end post
    sections; notch detail moved to A-2
    - Quotes updated (cedar ~10.24k, PT ~9.08k)
    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
    [orcamento.xlsx, privacy-screen.dxf]
2026-11-10 Privacy screen rev 4: end-post faces flush with the outer side
    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
    [privacy-screen.dxf]
2026-11-10 Privacy screen rev 5 (quotes + template): 10 posts by golden ratio, all faces flush
    - Spacing: 10 posts, clear span 23 5/16in, span/post = 4.24 = phi^3 (55/13),
    well under the 36in warp limit for 2x4 wood slats
    - End posts: outer side in 1in board, all posts 5 1/2in, faces flush
    - Beams split in 3 pieces per line (splices over posts 4 and 7) to fit 8ft 2x8
    - Template: --previa mode (PNG only), per-post widths, automatic beam splices
    - Quotes rebuilt from drawing geometry: cedar ~9.77k, all-PT ~8.68k
    - Drawings in desenhos/ stay at rev 4 until the rev 5 previews are approved
    Claude-Session: https://claude.ai/code/session_01CiNmhbRgwgq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
    [orcamento.xlsx, precos.csv]
2026-11-10 Privacy screen rev 6: English drawings, 24in embedment, shop pre-cut, 7 and 10 post proposals
    - Drawings template in English (cad.set_idioma), notches on neighbor side,
    notched top boards with end caps, new detail 5, simplified 10-step sequence
    - Posts embedded 24in, machine auger rental + delivery, field labor split
    from shop pre-cut labor (new oficina_*/obra_* rates)
    - Coated trim-head deck screws instead of stainless
    - gerar_propostas.py builds 10-post, 7-post and all-PT specs from drawing
    geometry; quotes regenerated; English client proposals for 7 and 10 posts
    - desenhos/ PDF/DXF not regenerated yet (previews pending approval)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
    [orcamento.xlsx]
2026-11-10 Privacy screen rev 7 final: combined proposal PDF (7 and 10 posts) + drawings
    - Final drawings: desenhos/10-postes (A-1..A-3) and desenhos/7-postes (B-1..B-3)
    - propostas/Kitchen-Privacy-Screen-Proposals.pdf: scope, comparison,
    materials table (species, treatment, S4S finish, actual sizes, qty per
    option), both options' prices, sequence, terms + all drawing sheets
    - Buried cores explicitly PT Southern Yellow Pine ground contact; all
    visible cedar specified kiln-dried S4S (big-box 2x6/2x8 cedar is rough)
    - Template: per-option sheet prefix, species/finish notes, shorter notes
    - Skill docs: preview-before-PDF, language and finish conventions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
    [orcamento.xlsx, precos.csv, privacy-screen.dxf]
2026-11-10 Revise field labor to crew pace; landscaping as optional extra
    - Holes + posts fit in one day (10 posts: 8 h); notched boards, slats and
    faces drop-in rates lowered (pre-cut parts)
    - Landscaping strip removed from both quotes; priced separately as an
    optional extra in the proposal
    - gerar_tempo_etapas.py regenerates tempo-por-etapa.md
    - Totals: A (10 posts) 8,115; B (7 posts) 6,535; all-PT ref 7,005
    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
    [orcamento.xlsx]
2026-11-10 End-post side closure: 1 h per end (top fitting cuts)
    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
    [orcamento.xlsx]
2026-11-10 Option B: 100% treated pine S4S; no composite; stock-availability pricing clause
    - Option B (7 posts) now all pressure-treated SYP #2 Prime, planed S4S,
    stain after drying included; drawings B-1..B-3 relabeled PT
    - Proposal: per-option materials table, explicit 'no composite',
    material cost subject to stock availability (price table, finish note
    and terms)
    - Totals: A cedar 10 posts 8,211; B treated pine 7 posts 5,881
    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
    [orcamento.xlsx, privacy-screen.dxf]
2026-11-10 Organize by client: Bill / kitchen-privacy-screen; clean hub; cut plan
    - Move project to projetos-madeira/clientes/bill/kitchen-privacy-screen and
    generic plans to projetos-madeira/referencias/planos
    - Hub README lists clients/projects and the folder convention;
    CLAUDE.md + skill docs: every new quote goes in clientes/<client>/<project>
    - Client 'Bill' on drawings title block and proposal
    - Scripts find .claude/skills by walking up (location-independent)
    - New shop cut plan for option B (7 posts): parts list, purchase list,
    board-by-board cut diagrams, notch and top-board notch tables,
    1:1 templates (gerar_plano_corte.py)
    Claud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
    [orcamento.xlsx, precos.csv, privacy-screen.dxf]
2026-11-10 New project teste1/cerca-trancada: woven fence module study
    - New drawing template cerca_trancada.py (module elevation, section A-A,
    plan weave section B-B, site layout) with golden-ratio height and
    10'-0" module dividing the 40/60/40 ft runs into 14 identical modules
    - Module and full-fence preliminary quotes from drawing geometry
    (gerar_specs.py); new field labor rates for woven fence
    - Reference photo saved; hub README updated
    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
    [orcamento.xlsx, precos.csv]
2026-11-10 teste1 woven fence: prefabricated framed panel solution (preview)
    - cerca_trancada.py: shop-built panel with closed 4-corner grooved 2x4
    frame, profile/corner/section details, installation between posts
    (support blocks, 1x2 stops both sides, continuous cap), P-1..P-3 sheets
    - Project README updated with the panel solution and open questions
    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
2026-11-10 teste1 woven fence rev 2: cedar 5/8 boards, nails/screws, spray finish; requote
    - Panel solution quote rebuilt from drawing geometry: 1 panel + 1 post
    (1,128) and full 140 ft (13,001; shop 59.7 h + field 49.3 h)
    - Weave 2in groove for 5/8 cedar; panel ~126 lb; fastener notes on P-1
    - New rates: frame grooving, panel assembly, shop/field spray, panel
    install, support blocks, panel transport
    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
    [orcamento.xlsx, precos.csv]
2026-11-10 Bill rev 8 study: 6 posts, 8 ft, 36in embedment, 24 slats (preview)
    - New option C spec (orcamento-6-postes): PT 6x6 cores embedded 36in in
    16in footings, cedar cladding (2x8 faces ripped to 7in, 1x6 sides),
    24 cedar 2x2 slats per bay, 2x pergola (2x8 top boards, 11 2x6 rafters
    at posts + mid-bay), reference image saved
    - privacy_screen.py: fixed slat count (ripa.fiadas), rafters at posts +
    mid-bay, data-driven texts in callouts/sequence/parts list
    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
2026-11-10 Bill option C top detail: beams bolted to 4x4 core, faces stop below, no end cap
    - privacy_screen.py: viga.faceada (beams in the face plane, bolted to the
    core, face boards end under the beam), viga.fechamento (end cap on/off,
    angled beam ends), viga.parafusos_por_poste; detail 5 redrawn for this
    case; parts list, sequence and callouts follow the options
    - Option C uses 4 thru-bolts per post, no end caps; A/B unchanged
    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
2026-11-10 Bill option C: core comparison 4x4 / 4x6 / 6x6 for cedar and all-PT
    - gerar_opcao_c.py builds 6 specs from drawing geometry and runs quotes;
    orcamento-c/comparativo-nucleo.md summarizes totals
    - New price rows: PT 4x6, cedar/PT 2x2, cedar/PT 1x6 (estimates marked)
    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
    [orcamento.xlsx, precos.csv]
2026-11-10 Bill rev 9: 4x6 core, final drawings and proposal (cedar vs all-PT)
    - Template: rectangular core (poste.nucleo_prof) so a 4x6 sits with 5 1/2"
    across the fence while posts stay 5 1/2" wide
    - Final drawings: desenhos/rev9-a-cedro (A-1..A-3), desenhos/rev9-b-pinus
    (B-1..B-3), PDF + DXF
    - propostas/Kitchen-Privacy-Screen-Proposal-rev9.pdf: same design, Option A
    cedar 7,580 / Option B all treated pine 6,742, materials table, stock-
    availability clause, landscaping extra, sequence + all sheets
    - rev 7 proposal and drawings archived
    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
    [orcamento.xlsx, privacy-screen.dxf]
2026-11-10 Bill rev 10 (preview): 4x top lumber — 4x8 beams, 4x6 rafters
    - Option C specs/quotes: beams 4x8 and rafters 4x6 (cedar or PT), 1/2x14
    thru-bolts; cedar 8,297 / all-PT 7,140 (prices of 4x cedar/PT estimated)
    - Final PDFs/proposal not regenerated yet (awaiting preview approval)
    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
    [orcamento.xlsx, precos.csv]
2026-11-10 Bill: modelo 3D (three.js) da cerca rev9 com vistas de detalhe
    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
2026-11-10 Bill: página 3D para celular (opções A/B, botões de vista, toque)
    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
2026-11-10 Bill: ganchos de câmera na página 3D (para gerar quadros do vídeo)
    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
2026-11-10 Bill rev 9.1: Option A + Ready Seal Natural Cedar stain/sealer on all cedar
    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
    [orcamento.xlsx, precos.csv]
2026-11-11 Bill rev 9.1: proposal generator (Option A stained & sealed) + rev 9 Option B base
    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
    [orcamento.xlsx]
2026-11-11 Bill rev 9.1 proposal: lumber-to-buy table with stock lengths; core cut length
    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
